AnturyXD/Soldering-stationV2/docs/images/t12-handle-internal-2.jpg

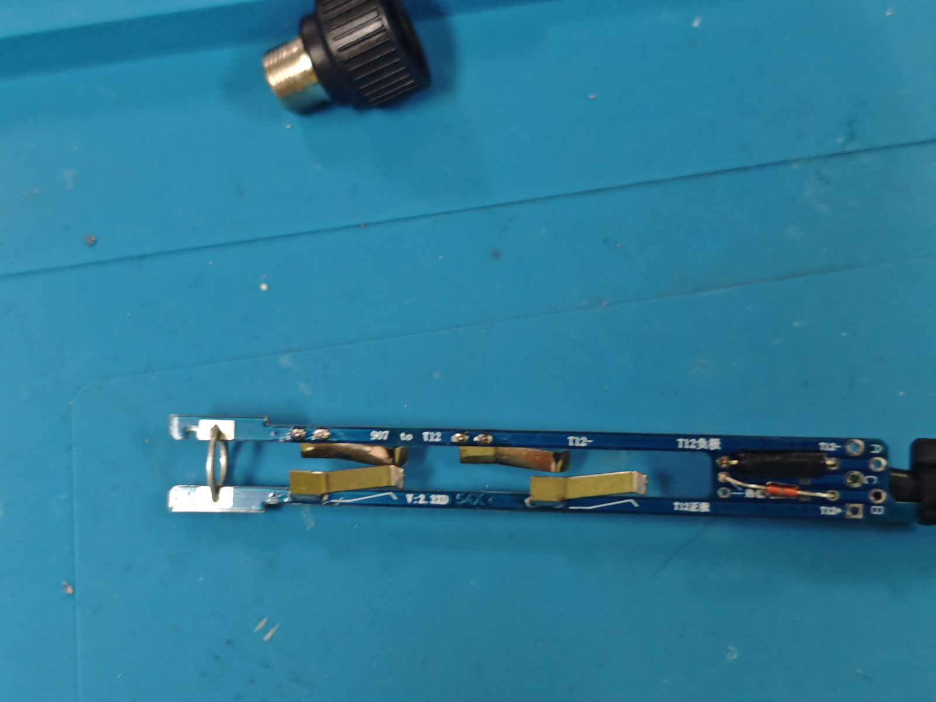
docs/images/t12-handle-internal-2.jpg
