AnturyXD/Soldering-stationV2/拓展板/Hardware/BOM_Board1_Schematic1_2026-06-07.xlsx

No. | Quantity | Comment | Designator | Footprint | Value | Manufacturer Part | Manufacturer | Supplier Part | Supplier | Name | Color
1 | 1 | 100uF | C1 | CAP-SMD_BD6.3-L6.6-W6.6-LS7.3-FD-H7.7 | 100uF | JVJ50V100M6x8 | JIERR(捷而瑞) | C46550415 | LCSC | 100uF
2 | 5 | 22pF | C2,C8,C9,C12,C13 | C0603 | 22pF | CL10C220JB8NNNC | SAMSUNG(三星) | C1653 | LCSC | 22pF
3 | 2 | 10uF | C3,C5 | C0603 | 10uF | CL10A106KP8NNNC | SAMSUNG(三星) | C19702 | LCSC | 10uF
4 | 10 | 100nF | C4,C6,C10,C11,C14,C15,C16,C17,C18,C19 | C0603 | 100nF | CGA0603X7R104K500JT | HRE(芯声) | C6119867 | LCSC | 100nF
5 | 1 | 220uF | C7 | CAP-SMD_BD10.0-L10.3-W10.3-LS11.7-FD | 220uF | JVJ50V220M10x10 | JIERR(捷而瑞) | C46550417 | LCSC | 220uF
6 | 2 | WJ2EDGVC-5.08-02P-14-00A | CN1,CN3 | CONN-TH_WJ2EDGVC-5.08-2P |  | WJ2EDGVC-5.08-02P-14-00A | KANGNEX(康奈克斯电气) | C8445 | LCSC | WJ2EDGVC-5.08-02P-14-00A | 绿色
7 | 1 | HX25003-3A | CN2 | CONN-TH_3P-P2.50_HX25003-3A |  | HX25003-3A | HX(红星) | C442300 | LCSC | HX25003-3A | 白色
8 | 4 | HX25003-2A | CN4,CN5,CN6,CN7 | CONN-TH_2P-P2.50_HX25003-2A |  | HX25003-2A | HX(红星) | C442299 | LCSC | HX25003-2A | 白色
9 | 1 | SS34 | D1 | SMA_L4.3-W2.6-LS5.2-RD |  | SS34 | MDD(辰达半导体) | C8678 | LCSC | SS34
10 | 3 | LL4148-GS08 | D2,D3,D4 | SOD-80_L3.5-W1.5-RD |  | LL4148-GS08 | VISHAY(威世) | C68883 | LCSC | LL4148-GS08
11 | 1 | PZ254V-11-04P | H1 | HDR-TH_4P-P2.54-V-M |  | PZ254V-11-04P | XFCN(兴飞) | C2691448 | LCSC | PZ254V-11-04P | 黑色
12 | 1 | PM254V-11-07-H85 | H2 | HDR-TH_7P-P2.54-V-F |  | PM254V-11-07-H85 | XFCN(兴飞) | C2832270 | LCSC | PM254V-11-07-H85
13 | 1 | PM254V-12-08-H85 | H3 | HDR-TH_8P-P2.54-V-F-R2-C4-S2.54 |  | PM254V-12-08-H85 | XFCN(兴飞) | C2834799 | LCSC | PM254V-12-08-H85
14 | 1 | 2.2uH | L1 | IND-SMD_L4.4-W4.2 | 2.2uH | FXL0420-2R2-M | cjiang(长江微电) | C167206 | LCSC | 2.2uH
15 | 1 | 47uH | L2 | IND-SMD_L12.3-W12.3 | 47uH | CDRH127N-470M | MINGSTAR(登壹) | C962356 | LCSC | 47uH
16 | 1 | NCD0603R1 | LED1 | LED0603-RD_RED |  | NCD0603R1 | 国星光电 | C84263 | LCSC | NCD0603R1
17 | 2 | NCD0603C1 | LED2,LED3 | LED0603-RD |  | NCD0603C1 | 国星光电 | C84264 | LCSC | NCD0603C1
18 | 3 | 19-219/GHC-YR2T1B5Y/3T | LED4,LED5,LED6 | LED-SMD_L1.6-W0.8_19-219-GHC-YR2T1B5Y-3T |  | 19-219/GHC-YR2T1B5Y/3T | EVERLIGHT(亿光) | C2994781 | LCSC | 19-219/GHC-YR2T1B5Y/3T
19 | 3 | S8050 J3Y | Q1,Q2,Q3 | SOT-23-3_L2.9-W1.3-P0.95-LS2.4-BR |  | S8050 J3Y | TDSEMIC(拓电半导体) | C42441446 | LCSC | S8050 J3Y
20 | 2 | 5.1kΩ | R1,R4 | R0603 | 5.1kΩ | 0603WAF5101T5E | UNI-ROYAL(厚声) | C23186 | LCSC | 5.1kΩ
21 | 1 | 100kΩ | R2 | R0603 | 100kΩ | 0603WAF1003T5E | UNI-ROYAL(厚声) | C25803 | LCSC | 100kΩ
22 | 1 | 22.1kΩ | R3 | R0603 | 22.1kΩ | FRC0603F2212TS | FOJAN(富捷) | C2960862 | LCSC | 22.1kΩ
23 | 3 | 1kΩ | R5,R6,R7 | R0603 | 1kΩ | FRC0603F1001TS | FOJAN(富捷) | C2907002 | LCSC | 1kΩ
24 | 4 | 10kΩ | R8,R9,R10,R12 | R0805 | 10kΩ | 0805W8F1002T5E | UNI-ROYAL(厚声) | C17414 | LCSC | 10kΩ
25 | 1 | 1.5kΩ | R11 | R0805 | 1.5kΩ | 0805W8F1501T5E | UNI-ROYAL(厚声) | C4310 | LCSC | 1.5kΩ
26 | 3 | 1.2kΩ | R13,R16,R19 | R0805 | 1.2kΩ | 0805W8F1201T5E | UNI-ROYAL(厚声) | C17379 | LCSC | 1.2kΩ
27 | 3 | 470Ω | R14,R17,R20 | R0805 | 470Ω | 0805W8F4700T5E | UNI-ROYAL(厚声) | C17710 | LCSC | 470Ω
28 | 3 | 2kΩ | R15,R18,R21 | R0805 | 2kΩ | 0805W8F2001T5E | UNI-ROYAL(厚声) | C17604 | LCSC | 2kΩ
29 | 3 | SRD-05VDC-SL-C | RLY1,RLY2,RLY3 | RELAY-TH_SRD-XXVDC-XL-C |  | SRD-05VDC-SL-C | 松乐 | C35449 | LCSC | SRD-05VDC-SL-C
30 | 4 | M3螺丝 | SCREW1,SCREW2,SCREW3,SCREW4 | M3螺丝
31 | 3 | KH-6X6X5H-STM | SW1,SW2,SW3 | SW-SMD_4P-L6.0-W6.0-P4.50-LS9.0_H5.0 |  | KH-6X6X5H-STM | kinghelm(金航标) | C2837531 | LCSC | KH-6X6X5H-STM
32 | 1 | SY8089AAAC | U1 | SOT-23-5_L3.0-W1.7-P0.95-LS2.8-BR |  | SY8089AAAC | Silergy(矽力杰) | C78988 | LCSC | SY8089AAAC
33 | 1 | CH213K | U2 | SOT-23-3_L2.9-W1.6-P1.90-LS2.8-BR |  | CH213K | WCH(南京沁恒) | C5456874 | LCSC | CH213K
34 | 1 | LM2596S-5.0/NOPB | U3 | TO-263-5_L10.2-W8.6-P1.70-LS14.4-BR |  | LM2596S-5.0/NOPB | TI(德州仪器) | C116713 | LCSC | LM2596S-5.0/NOPB
35 | 1 | STM32F103C8T6 | U4 | LQFP-48_L7.0-W7.0-P0.50-LS9.0-BL |  | STM32F103C8T6 | ST(意法半导体) | C8734 | LCSC | STM32F103C8T6
36 | 1 | CH340N | U5 | SOP-8_L4.9-W3.9-P1.27-LS6.0-BL |  | CH340N | WCH(南京沁恒) | C2977777 | LCSC | CH340N
37 | 1 | HDGCPH-PZ01-20 | U6 | HDR-TH_20P-P2.54-V-M_1 |  | HDGCPH-PZ01-20 | HDGC(华德共创) | C19190986 | LCSC | HDGCPH-PZ01-20 | 黑色
38 | 3 | LTV-354T-A | U7,U8,U9 | SOP-4_L3.9-W4.4-P2.54-LS7.0-TL |  | LTV-354T-A | LITEON(光宝) | C10802 | LCSC | LTV-354T-A
39 | 1 | TYPE-C 16PIN 2MD(073) | USB1 | USB-C-SMD_TYPE-C-16PIN-2MD-073 |  | TYPE-C 16PIN 2MD(073) | SHOU HAN(首韩) | C2765186 | LCSC | TYPE-C 16PIN 2MD(073)
40 | 1 | 8MHz | X1 | CRYSTAL-SMD_L5.0-W3.2 | 8MHz | X50328MSB2GI | YXC(扬兴晶振) | C115962 | LCSC | 8MHz
41 | 1 | 32.768kHz | X2 | CRYSTAL-SMD_L3.2-W1.5-1 | 32.768kHz | XKXGI-SUA-32.768K | YXC(扬兴晶振) | C5213671 | LCSC | 32.768kHz
