AnturyXD/Soldering-stationV2/控温板/Hardware/BOM_T12焊台温控_智能焊台控制板_2026-06-07.xlsx

No. | Quantity | Comment | Designator | Footprint | Value | Manufacturer Part | Manufacturer | Supplier Part | Supplier | Name | Color
1 | 1 | 2.7kHz | BUZZER2 | BUZ-TH_BD9.0-P4.00-D0.6-FD | 2.7kHz | QMB-09B-03 | 华能 | C96256 | LCSC | 2.7kHz
2 | 2 | 22pF | C1,C2 | C0603 | 22pF | CL10C220JB8NNNC | SAMSUNG(三星) | C1653 | LCSC | 22pF
3 | 6 | 100nF | C3,C4,C6,C8,C9,C13 | C0603 | 100nF | CGA0603X7R104K500JT | HRE(芯声) | C6119867 | LCSC | 100nF
4 | 1 | 47uF | C5 | CAP-TH_BD8.0-P3.50-D0.6-FD | 47uF | PA100V47M8X11 | JIERR(捷而瑞) | C49233039 | LCSC | 47uF
5 | 1 | 10uF | C7 | C0603 | 10uF | HGC0603R5106M350NTHJ | Chinocera(华瓷) | C22367827 | LCSC | 10uF
6 | 1 | 22uF | C10 | CAP-SMD_BD5.0-L5.3-W5.3-LS6.0-FD-H5.7 | 22uF | JVE35V22M5X6 | JIERR(捷而瑞) | C48615118 | LCSC | 22uF
7 | 1 | 1uF | C11 | C0603 | 1uF | CL10A105KB8NNNC | SAMSUNG(三星) | C15849 | LCSC | 1uF
8 | 1 | 2.2nF | C12 | C0603 | 2.2nF | FCC0603B222K500CT | FOJAN(富捷) | C5137562 | LCSC | 2.2nF
9 | 1 | HX25003-2A | CN2 | CONN-TH_2P-P2.50_HX25003-2A |  | HX25003-2A | HX(红星) | C442299 | LCSC | HX25003-2A | 白色
10 | 1 | SS54 | D1 | SMB_L4.3-W3.6-LS5.4-RD |  | SS54 | HXY MOSFET(华轩阳电子) | C5200096 | LCSC | SS54
11 | 1 | BZT52C18 | D2 | SOD-123_L2.7-W1.6-LS3.7-RD |  | BZT52C18 | R+O(宏嘉诚) | C19077414 | LCSC | BZT52C18
12 | 1 | LUDZS5.1BT1G | D3 | SOD-323_L1.8-W1.3-LS2.5-RD |  | LUDZS5.1BT1G | LRC(乐山无线电) | C49585 | LCSC | LUDZS5.1BT1G
13 | 2 | 1N4148WS | D4,D6 | SOD-323_L1.8-W1.3-LS2.5-RD |  | 1N4148WS | CJ(江苏长电/长晶) | C2128 | LCSC | 1N4148WS
14 | 1 | PZ254V-12-6P | J1 | HDR-TH_6P-P2.54-V-M-R2-C3-S2.54 |  | PZ254V-12-6P | XFCN(兴飞) | C492420 | LCSC | PZ254V-12-6P | 黑色
15 | 2 | PZ254V-11-01P | J2,J3 | HDR-TH_1P-P2.54-V-M |  | PZ254V-11-01P | XFCN(兴飞) | C492400 | LCSC | PZ254V-11-01P | 黑色
16 | 1 | KH-6X6X5H-STM | KEY1 | SW-SMD_4P-L6.0-W6.0-P4.50-LS9.0_H5.0 |  | KH-6X6X5H-STM | kinghelm(金航标) | C2837531 | LCSC | KH-6X6X5H-STM
17 | 1 | YLED0603B | LED1 | LED0603-FD |  | YLED0603B | YONGYUTAI(永裕泰) | C19171394 | LCSC | YLED0603B
18 | 1 | HS96L03W2C03 | OLED1 | OLED-TH_L27.8-W27.2-P2.54_C9900033791 |  | HS96L03W2C03 | HS(汉昇) | C5248080 | LCSC | HS96L03W2C03
19 | 1 | Aviator Socket | P1 | GX12-5 |  | GX16-5-01 |  |  |  | Aviator Socket
20 | 1 | WJ2EDGVC-5.08-02P-14-00A | P2 | CONN-TH_WJ2EDGVC-5.08-2P |  | WJ2EDGVC-5.08-02P-14-00A | KANGNEX(康奈克斯电气) | C8445 | LCSC | WJ2EDGVC-5.08-02P-14-00A | 绿色
21 | 1 | IRLR7843TRPBF | Q1 | TO-252-2_L6.5-W6.1-P4.58-LS10.0-TR |  | IRLR7843TRPBF | Infineon(英飞凌) | C21988 | LCSC | IRLR7843TRPBF
22 | 1 | FMMT619TA-HXY | Q2 | SOT-23-3_L2.9-W1.6-P1.90-LS2.8-BR |  | FMMT619TA-HXY | HXY MOSFET(华轩阳电子) | C47506859 | LCSC | FMMT619TA-HXY
23 | 1 | SS8050 | Q4 | SOT-23-3_L2.9-W1.3-P1.90-LS2.4-BR |  | SS8050 | R+O(宏嘉诚) | C7420370 | LCSC | SS8050
24 | 12 | 10kΩ | R1,R2,R3,R5,R7,R8,R9,R10,R13,R14,R17,R19 | R0603 | 10kΩ | FRC0603J103 TS | FOJAN(富捷) | C2930027 | LCSC | 10kΩ
25 | 1 | 1kΩ | R4 | R1206 | 1kΩ | 1206W4F1001T5E | UNI-ROYAL(厚声) | C4410 | LCSC | 1kΩ
26 | 1 | 47kΩ | R6 | R0603 | 47kΩ | FRC0603F4702TS | FOJAN(富捷) | C2907042 | LCSC | 47kΩ
27 | 1 | 200kΩ | R11 | R0603 | 200kΩ | 0603WAF2003T5E | UNI-ROYAL(厚声) | C25811 | LCSC | 200kΩ
28 | 1 | 1kΩ | R12 | R0603 | 1kΩ | FRC0603F1001TS | FOJAN(富捷) | C2907002 | LCSC | 1kΩ
29 | 1 | 1.5kΩ | R16 | R0603 | 1.5kΩ | FRC0603F1501TS | FOJAN(富捷) | C2930050 | LCSC | 1.5kΩ
30 | 1 | 20kΩ | R18 | R0603 | 20kΩ | FRC0603F2002TS | FOJAN(富捷) | C2907011 | LCSC | 20kΩ
31 | 1 | EC11E153440D | SW1 | SW-TH_EC11XXXXXXXX |  | EC11E153440D | ALPSALPINE(阿尔卑斯阿尔派) | C370992 | LCSC | EC11E153440D
32 | 1 | ATMEGA328P-AU | U1 | TQFP-32_L7.0-W7.0-P0.80-LS9.0-BL |  | ATMEGA328P-AU | MICROCHIP(美国微芯) | C14877 | LCSC | ATMEGA328P-AU
33 | 1 | L78M05ABDT-TR | U2 | TO-252-2_L6.5-W6.1-P4.58-LS10.0-TL |  | L78M05ABDT-TR | ST(意法半导体) | C58069 | LCSC | L78M05ABDT-TR
34 | 1 | OPA2333AIDR | U3 | SOP-8_L4.9-W3.9-P1.27-LS6.0-BL |  | OPA2333AIDR | TI(德州仪器) | C38732 | LCSC | OPA2333AIDR
35 | 1 | 16MHz | X1 | CRYSTAL-SMD_4P-L3.2-W2.5-BL | 16MHz | X322516MLB4SI | YXC(扬兴晶振) | C13738 | LCSC | 16MHz
