AnturyXD/Soldering-stationV2/ATmega-Soldering-Station-master/3dprint/SolderingStationV2_knob.fcstd

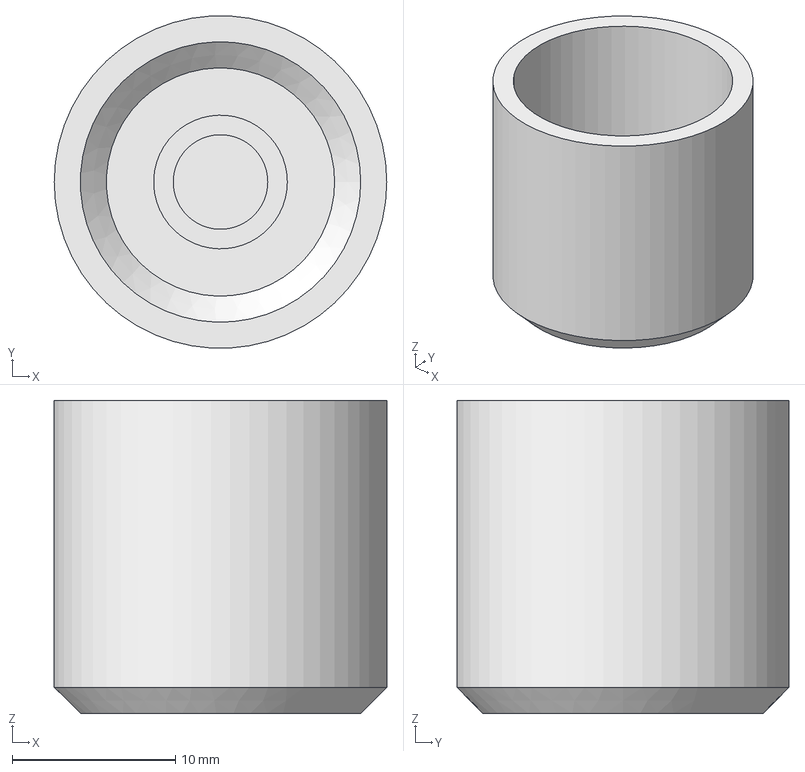
[picture p21: CAD file, 2026-06-06, last stored version]
ATmega-Soldering-Station-master/3dprint/SolderingStationV2_knob.fcstd
20.4 x 20.4 x 19.2 mm
