AnturyXD/Soldering-stationV2/ATmega-Soldering-Station-master/3dprint/SolderungStationV2_Case_ESD.fcstd

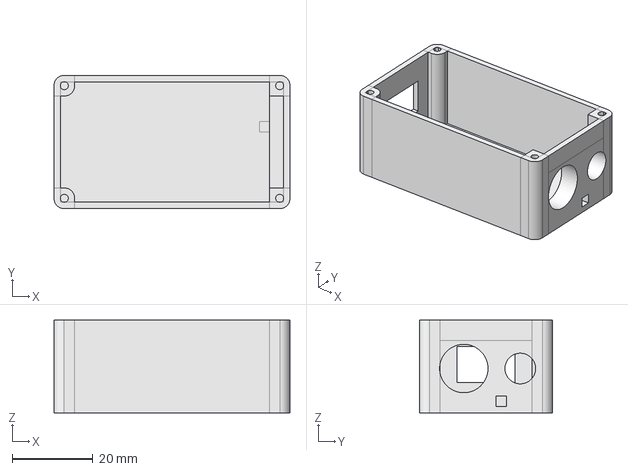
[picture p22: CAD file, 2026-06-06, last stored version]
ATmega-Soldering-Station-master/3dprint/SolderungStationV2_Case_ESD.fcstd
58.5 x 33.0 x 23.0 mm
