AnturyXD/Soldering-stationV2/(list of files, cad)

Other CAD files:
ATmega-Soldering-Station-master/3dprint/SolderingStationV2_knob.stl
ATmega-Soldering-Station-master/3dprint/SolderungStationV2_Case_ESD.stl
