AnturyXD/Soldering-stationV2/拓展板/Firmware/SmartSolder_Extension/C8T6/USER/Objects/SmartSolder_Extension.htm

# Static Call Graph for image .\Objects\SmartSolder_Extension.axf

#<CALLGRAPH># ARM Linker, 5060750: Last Updated: Wed Jun 10 21:04:14 2026

### Maximum Stack Usage = 328 bytes + Unknown(Cycles, Untraceable Function Pointers)

### Call chain for Maximum Stack Depth:

main ⇒ App_ReportTask ⇒ DebugUart_Printf ⇒ DebugUart_PushByte ⇒ DebugUart_KickLocked

### Mutually Recursive functions

- ADC1_2_IRQHandler ⇒ ADC1_2_IRQHandler

### Function Pointers

- ADC1_2_IRQHandler from startup_stm32f10x_md.o(.text) referenced from startup_stm32f10x_md.o(RESET)
- BusFault_Handler from stm32f10x_it.o(i.BusFault_Handler) referenced from startup_stm32f10x_md.o(RESET)
- CAN1_RX1_IRQHandler from startup_stm32f10x_md.o(.text) referenced from startup_stm32f10x_md.o(RESET)
- CAN1_SCE_IRQHandler from startup_stm32f10x_md.o(.text) referenced from startup_stm32f10x_md.o(RESET)
- DMA1_Channel1_IRQHandler from startup_stm32f10x_md.o(.text) referenced from startup_stm32f10x_md.o(RESET)
- DMA1_Channel2_IRQHandler from startup_stm32f10x_md.o(.text) referenced from startup_stm32f10x_md.o(RESET)
- DMA1_Channel3_IRQHandler from st7789.o(i.DMA1_Channel3_IRQHandler) referenced from startup_stm32f10x_md.o(RESET)
- DMA1_Channel4_IRQHandler from debug_uart.o(i.DMA1_Channel4_IRQHandler) referenced from startup_stm32f10x_md.o(RESET)
- DMA1_Channel5_IRQHandler from startup_stm32f10x_md.o(.text) referenced from startup_stm32f10x_md.o(RESET)
- DMA1_Channel6_IRQHandler from startup_stm32f10x_md.o(.text) referenced from startup_stm32f10x_md.o(RESET)
- DMA1_Channel7_IRQHandler from startup_stm32f10x_md.o(.text) referenced from startup_stm32f10x_md.o(RESET)
- DebugMon_Handler from stm32f10x_it.o(i.DebugMon_Handler) referenced from startup_stm32f10x_md.o(RESET)
- EXTI0_IRQHandler from startup_stm32f10x_md.o(.text) referenced from startup_stm32f10x_md.o(RESET)
- EXTI15_10_IRQHandler from startup_stm32f10x_md.o(.text) referenced from startup_stm32f10x_md.o(RESET)
- EXTI1_IRQHandler from startup_stm32f10x_md.o(.text) referenced from startup_stm32f10x_md.o(RESET)
- EXTI2_IRQHandler from startup_stm32f10x_md.o(.text) referenced from startup_stm32f10x_md.o(RESET)
- EXTI3_IRQHandler from startup_stm32f10x_md.o(.text) referenced from startup_stm32f10x_md.o(RESET)
- EXTI4_IRQHandler from startup_stm32f10x_md.o(.text) referenced from startup_stm32f10x_md.o(RESET)
- EXTI9_5_IRQHandler from startup_stm32f10x_md.o(.text) referenced from startup_stm32f10x_md.o(RESET)
- FLASH_IRQHandler from startup_stm32f10x_md.o(.text) referenced from startup_stm32f10x_md.o(RESET)
- HardFault_Handler from stm32f10x_it.o(i.HardFault_Handler) referenced from startup_stm32f10x_md.o(RESET)
- I2C1_ER_IRQHandler from startup_stm32f10x_md.o(.text) referenced from startup_stm32f10x_md.o(RESET)
- I2C1_EV_IRQHandler from startup_stm32f10x_md.o(.text) referenced from startup_stm32f10x_md.o(RESET)
- I2C2_ER_IRQHandler from startup_stm32f10x_md.o(.text) referenced from startup_stm32f10x_md.o(RESET)
- I2C2_EV_IRQHandler from startup_stm32f10x_md.o(.text) referenced from startup_stm32f10x_md.o(RESET)
- MemManage_Handler from stm32f10x_it.o(i.MemManage_Handler) referenced from startup_stm32f10x_md.o(RESET)
- NMI_Handler from stm32f10x_it.o(i.NMI_Handler) referenced from startup_stm32f10x_md.o(RESET)
- PVD_IRQHandler from startup_stm32f10x_md.o(.text) referenced from startup_stm32f10x_md.o(RESET)
- PendSV_Handler from stm32f10x_it.o(i.PendSV_Handler) referenced from startup_stm32f10x_md.o(RESET)
- RCC_IRQHandler from startup_stm32f10x_md.o(.text) referenced from startup_stm32f10x_md.o(RESET)
- RTCAlarm_IRQHandler from startup_stm32f10x_md.o(.text) referenced from startup_stm32f10x_md.o(RESET)
- RTC_IRQHandler from startup_stm32f10x_md.o(.text) referenced from startup_stm32f10x_md.o(RESET)
- Reset_Handler from startup_stm32f10x_md.o(.text) referenced from startup_stm32f10x_md.o(RESET)
- SPI1_IRQHandler from startup_stm32f10x_md.o(.text) referenced from startup_stm32f10x_md.o(RESET)
- SPI2_IRQHandler from startup_stm32f10x_md.o(.text) referenced from startup_stm32f10x_md.o(RESET)
- SVC_Handler from stm32f10x_it.o(i.SVC_Handler) referenced from startup_stm32f10x_md.o(RESET)
- SysTick_Handler from stm32f10x_it.o(i.SysTick_Handler) referenced from startup_stm32f10x_md.o(RESET)
- TAMPER_IRQHandler from startup_stm32f10x_md.o(.text) referenced from startup_stm32f10x_md.o(RESET)
- TIM1_BRK_IRQHandler from startup_stm32f10x_md.o(.text) referenced from startup_stm32f10x_md.o(RESET)
- TIM1_CC_IRQHandler from startup_stm32f10x_md.o(.text) referenced from startup_stm32f10x_md.o(RESET)
- TIM1_TRG_COM_IRQHandler from startup_stm32f10x_md.o(.text) referenced from startup_stm32f10x_md.o(RESET)
- TIM1_UP_IRQHandler from startup_stm32f10x_md.o(.text) referenced from startup_stm32f10x_md.o(RESET)
- TIM2_IRQHandler from startup_stm32f10x_md.o(.text) referenced from startup_stm32f10x_md.o(RESET)
- TIM3_IRQHandler from timer.o(i.TIM3_IRQHandler) referenced from startup_stm32f10x_md.o(RESET)
- TIM4_IRQHandler from startup_stm32f10x_md.o(.text) referenced from startup_stm32f10x_md.o(RESET)
- USART1_IRQHandler from startup_stm32f10x_md.o(.text) referenced from startup_stm32f10x_md.o(RESET)
- USART2_IRQHandler from esp_uart.o(i.USART2_IRQHandler) referenced from startup_stm32f10x_md.o(RESET)
- USART3_IRQHandler from lower_uart.o(i.USART3_IRQHandler) referenced from startup_stm32f10x_md.o(RESET)
- USBWakeUp_IRQHandler from startup_stm32f10x_md.o(.text) referenced from startup_stm32f10x_md.o(RESET)
- USB_HP_CAN1_TX_IRQHandler from startup_stm32f10x_md.o(.text) referenced from startup_stm32f10x_md.o(RESET)
- USB_LP_CAN1_RX0_IRQHandler from startup_stm32f10x_md.o(.text) referenced from startup_stm32f10x_md.o(RESET)
- UsageFault_Handler from stm32f10x_it.o(i.UsageFault_Handler) referenced from startup_stm32f10x_md.o(RESET)
- WWDG_IRQHandler from startup_stm32f10x_md.o(.text) referenced from startup_stm32f10x_md.o(RESET)
- __main from entry.o(.ARM.Collect$$$$00000000) referenced from startup_stm32f10x_md.o(.text)
- _snputc from printfa.o(i._snputc) referenced from printfa.o(i.__0snprintf)
- _snputc from printfa.o(i._snputc) referenced from printfa.o(i.__0vsnprintf)
- main from main.o(i.main) referenced from entry9a.o(.ARM.Collect$$$$0000000B)

### Global Symbols

__main (Thumb, 0 bytes, Stack size unknown bytes, entry.o(.ARM.Collect$$$$00000000))
[Address Reference Count : 1]

- startup_stm32f10x_md.o(.text)

_main_stk (Thumb, 0 bytes, Stack size unknown bytes, entry2.o(.ARM.Collect$$$$00000001))

_main_scatterload (Thumb, 0 bytes, Stack size unknown bytes, entry5.o(.ARM.Collect$$$$00000004))

[Calls]

- >> __scatterload

__main_after_scatterload (Thumb, 0 bytes, Stack size unknown bytes, entry5.o(.ARM.Collect$$$$00000004))

[Called By]

- >> __scatterload

_main_clock (Thumb, 0 bytes, Stack size unknown bytes, entry7b.o(.ARM.Collect$$$$00000008))

_main_cpp_init (Thumb, 0 bytes, Stack size unknown bytes, entry8b.o(.ARM.Collect$$$$0000000A))

_main_init (Thumb, 0 bytes, Stack size unknown bytes, entry9a.o(.ARM.Collect$$$$0000000B))

__rt_final_cpp (Thumb, 0 bytes, Stack size unknown bytes, entry10a.o(.ARM.Collect$$$$0000000D))

__rt_final_exit (Thumb, 0 bytes, Stack size unknown bytes, entry11a.o(.ARM.Collect$$$$0000000F))

Reset_Handler (Thumb, 4 bytes, Stack size 0 bytes, startup_stm32f10x_md.o(.text))
[Address Reference Count : 1]

- startup_stm32f10x_md.o(RESET)

ADC1_2_IRQHandler (Thumb, 0 bytes, Stack size 0 bytes, startup_stm32f10x_md.o(.text))

[Calls]

- >> ADC1_2_IRQHandler

[Called By]

- >> ADC1_2_IRQHandler

[Address Reference Count : 1]

- startup_stm32f10x_md.o(RESET)

CAN1_RX1_IRQHandler (Thumb, 0 bytes, Stack size 0 bytes, startup_stm32f10x_md.o(.text))
[Address Reference Count : 1]

- startup_stm32f10x_md.o(RESET)

CAN1_SCE_IRQHandler (Thumb, 0 bytes, Stack size 0 bytes, startup_stm32f10x_md.o(.text))
[Address Reference Count : 1]

- startup_stm32f10x_md.o(RESET)

DMA1_Channel1_IRQHandler (Thumb, 0 bytes, Stack size 0 bytes, startup_stm32f10x_md.o(.text))
[Address Reference Count : 1]

- startup_stm32f10x_md.o(RESET)

DMA1_Channel2_IRQHandler (Thumb, 0 bytes, Stack size 0 bytes, startup_stm32f10x_md.o(.text))
[Address Reference Count : 1]

- startup_stm32f10x_md.o(RESET)

DMA1_Channel5_IRQHandler (Thumb, 0 bytes, Stack size 0 bytes, startup_stm32f10x_md.o(.text))
[Address Reference Count : 1]

- startup_stm32f10x_md.o(RESET)

DMA1_Channel6_IRQHandler (Thumb, 0 bytes, Stack size 0 bytes, startup_stm32f10x_md.o(.text))
[Address Reference Count : 1]

- startup_stm32f10x_md.o(RESET)

DMA1_Channel7_IRQHandler (Thumb, 0 bytes, Stack size 0 bytes, startup_stm32f10x_md.o(.text))
[Address Reference Count : 1]

- startup_stm32f10x_md.o(RESET)

EXTI0_IRQHandler (Thumb, 0 bytes, Stack size 0 bytes, startup_stm32f10x_md.o(.text))
[Address Reference Count : 1]

- startup_stm32f10x_md.o(RESET)

EXTI15_10_IRQHandler (Thumb, 0 bytes, Stack size 0 bytes, startup_stm32f10x_md.o(.text))
[Address Reference Count : 1]

- startup_stm32f10x_md.o(RESET)

EXTI1_IRQHandler (Thumb, 0 bytes, Stack size 0 bytes, startup_stm32f10x_md.o(.text))
[Address Reference Count : 1]

- startup_stm32f10x_md.o(RESET)

EXTI2_IRQHandler (Thumb, 0 bytes, Stack size 0 bytes, startup_stm32f10x_md.o(.text))
[Address Reference Count : 1]

- startup_stm32f10x_md.o(RESET)

EXTI3_IRQHandler (Thumb, 0 bytes, Stack size 0 bytes, startup_stm32f10x_md.o(.text))
[Address Reference Count : 1]

- startup_stm32f10x_md.o(RESET)

EXTI4_IRQHandler (Thumb, 0 bytes, Stack size 0 bytes, startup_stm32f10x_md.o(.text))
[Address Reference Count : 1]

- startup_stm32f10x_md.o(RESET)

EXTI9_5_IRQHandler (Thumb, 0 bytes, Stack size 0 bytes, startup_stm32f10x_md.o(.text))
[Address Reference Count : 1]

- startup_stm32f10x_md.o(RESET)

FLASH_IRQHandler (Thumb, 0 bytes, Stack size 0 bytes, startup_stm32f10x_md.o(.text))
[Address Reference Count : 1]

- startup_stm32f10x_md.o(RESET)

I2C1_ER_IRQHandler (Thumb, 0 bytes, Stack size 0 bytes, startup_stm32f10x_md.o(.text))
[Address Reference Count : 1]

- startup_stm32f10x_md.o(RESET)

I2C1_EV_IRQHandler (Thumb, 0 bytes, Stack size 0 bytes, startup_stm32f10x_md.o(.text))
[Address Reference Count : 1]

- startup_stm32f10x_md.o(RESET)

I2C2_ER_IRQHandler (Thumb, 0 bytes, Stack size 0 bytes, startup_stm32f10x_md.o(.text))
[Address Reference Count : 1]

- startup_stm32f10x_md.o(RESET)

I2C2_EV_IRQHandler (Thumb, 0 bytes, Stack size 0 bytes, startup_stm32f10x_md.o(.text))
[Address Reference Count : 1]

- startup_stm32f10x_md.o(RESET)

PVD_IRQHandler (Thumb, 0 bytes, Stack size 0 bytes, startup_stm32f10x_md.o(.text))
[Address Reference Count : 1]

- startup_stm32f10x_md.o(RESET)

RCC_IRQHandler (Thumb, 0 bytes, Stack size 0 bytes, startup_stm32f10x_md.o(.text))
[Address Reference Count : 1]

- startup_stm32f10x_md.o(RESET)

RTCAlarm_IRQHandler (Thumb, 0 bytes, Stack size 0 bytes, startup_stm32f10x_md.o(.text))
[Address Reference Count : 1]

- startup_stm32f10x_md.o(RESET)

RTC_IRQHandler (Thumb, 0 bytes, Stack size 0 bytes, startup_stm32f10x_md.o(.text))
[Address Reference Count : 1]

- startup_stm32f10x_md.o(RESET)

SPI1_IRQHandler (Thumb, 0 bytes, Stack size 0 bytes, startup_stm32f10x_md.o(.text))
[Address Reference Count : 1]

- startup_stm32f10x_md.o(RESET)

SPI2_IRQHandler (Thumb, 0 bytes, Stack size 0 bytes, startup_stm32f10x_md.o(.text))
[Address Reference Count : 1]

- startup_stm32f10x_md.o(RESET)

TAMPER_IRQHandler (Thumb, 0 bytes, Stack size 0 bytes, startup_stm32f10x_md.o(.text))
[Address Reference Count : 1]

- startup_stm32f10x_md.o(RESET)

TIM1_BRK_IRQHandler (Thumb, 0 bytes, Stack size 0 bytes, startup_stm32f10x_md.o(.text))
[Address Reference Count : 1]

- startup_stm32f10x_md.o(RESET)

TIM1_CC_IRQHandler (Thumb, 0 bytes, Stack size 0 bytes, startup_stm32f10x_md.o(.text))
[Address Reference Count : 1]

- startup_stm32f10x_md.o(RESET)

TIM1_TRG_COM_IRQHandler (Thumb, 0 bytes, Stack size 0 bytes, startup_stm32f10x_md.o(.text))
[Address Reference Count : 1]

- startup_stm32f10x_md.o(RESET)

TIM1_UP_IRQHandler (Thumb, 0 bytes, Stack size 0 bytes, startup_stm32f10x_md.o(.text))
[Address Reference Count : 1]

- startup_stm32f10x_md.o(RESET)

TIM2_IRQHandler (Thumb, 0 bytes, Stack size 0 bytes, startup_stm32f10x_md.o(.text))
[Address Reference Count : 1]

- startup_stm32f10x_md.o(RESET)

TIM4_IRQHandler (Thumb, 0 bytes, Stack size 0 bytes, startup_stm32f10x_md.o(.text))
[Address Reference Count : 1]

- startup_stm32f10x_md.o(RESET)

USART1_IRQHandler (Thumb, 0 bytes, Stack size 0 bytes, startup_stm32f10x_md.o(.text))
[Address Reference Count : 1]

- startup_stm32f10x_md.o(RESET)

USBWakeUp_IRQHandler (Thumb, 0 bytes, Stack size 0 bytes, startup_stm32f10x_md.o(.text))
[Address Reference Count : 1]

- startup_stm32f10x_md.o(RESET)

USB_HP_CAN1_TX_IRQHandler (Thumb, 0 bytes, Stack size 0 bytes, startup_stm32f10x_md.o(.text))
[Address Reference Count : 1]

- startup_stm32f10x_md.o(RESET)

USB_LP_CAN1_RX0_IRQHandler (Thumb, 0 bytes, Stack size 0 bytes, startup_stm32f10x_md.o(.text))
[Address Reference Count : 1]

- startup_stm32f10x_md.o(RESET)

WWDG_IRQHandler (Thumb, 0 bytes, Stack size 0 bytes, startup_stm32f10x_md.o(.text))
[Address Reference Count : 1]

- startup_stm32f10x_md.o(RESET)

__aeabi_memcpy (Thumb, 36 bytes, Stack size 0 bytes, memcpya.o(.text), UNUSED)

__aeabi_memcpy4 (Thumb, 0 bytes, Stack size 0 bytes, memcpya.o(.text))

[Called By]

- >> ESP01S_PopCommand
- >> DisplayUi_Task

__aeabi_memcpy8 (Thumb, 0 bytes, Stack size 0 bytes, memcpya.o(.text), UNUSED)

__aeabi_memset (Thumb, 14 bytes, Stack size 0 bytes, memseta.o(.text))

[Called By]

- >> ResetDrawCaches
- >> DrawBigDigit
- >> _memset$wrapper
- >> __aeabi_memclr

__aeabi_memset4 (Thumb, 0 bytes, Stack size 0 bytes, memseta.o(.text), UNUSED)

__aeabi_memset8 (Thumb, 0 bytes, Stack size 0 bytes, memseta.o(.text), UNUSED)

__aeabi_memclr (Thumb, 4 bytes, Stack size 0 bytes, memseta.o(.text), UNUSED)

[Calls]

- >> __aeabi_memset

__aeabi_memclr4 (Thumb, 0 bytes, Stack size 0 bytes, memseta.o(.text))

[Called By]

- >> AppState_Init
- >> HandleLine

__aeabi_memclr8 (Thumb, 0 bytes, Stack size 0 bytes, memseta.o(.text), UNUSED)

_memset$wrapper (Thumb, 18 bytes, Stack size 8 bytes, memseta.o(.text), UNUSED)

[Calls]

- >> __aeabi_memset

strstr (Thumb, 36 bytes, Stack size 12 bytes, strstr.o(.text))

[Stack]

- Max Depth = 12
- Call Chain = strstr

[Called By]

- >> ParseField

strncpy (Thumb, 24 bytes, Stack size 8 bytes, strncpy.o(.text))

[Stack]

- Max Depth = 8
- Call Chain = strncpy

[Called By]

- >> DrawWaitingInfo
- >> ESP01S_Task
- >> ApplyStatusFrame
- >> StoreIp

strchr (Thumb, 20 bytes, Stack size 0 bytes, strchr.o(.text))

[Called By]

- >> IsValidMode

strlen (Thumb, 14 bytes, Stack size 0 bytes, strlen.o(.text))

[Called By]

- >> ParseField

strcmp (Thumb, 28 bytes, Stack size 8 bytes, strcmp.o(.text))

[Stack]

- Max Depth = 8
- Call Chain = strcmp

[Called By]

- >> App_ProcessCommand

strcpy (Thumb, 18 bytes, Stack size 0 bytes, strcpy.o(.text))

[Called By]

- >> AppState_Init

strncmp (Thumb, 30 bytes, Stack size 12 bytes, strncmp.o(.text))

[Stack]

- Max Depth = 12
- Call Chain = strncmp

[Called By]

- >> DrawWaitingInfo
- >> ESP01S_Task
- >> ParseStatusFrame
- >> HandleLine

strtol (Thumb, 112 bytes, Stack size 32 bytes, strtol.o(.text))

[Stack]

- Max Depth = 72
- Call Chain = strtol ⇒ _strtoul

[Calls]

- >> _strtoul
- >> __aeabi_errno_addr
- >> __rt_ctype_table

[Called By]

- >> ParseNumber
- >> atoi

atoi (Thumb, 26 bytes, Stack size 16 bytes, atoi.o(.text))

[Stack]

- Max Depth = 88
- Call Chain = atoi ⇒ strtol ⇒ _strtoul

[Calls]

- >> __aeabi_errno_addr
- >> strtol

[Called By]

- >> HandleLine

__aeabi_uidiv (Thumb, 0 bytes, Stack size 12 bytes, uidiv.o(.text), UNUSED)

__aeabi_uidivmod (Thumb, 44 bytes, Stack size 12 bytes, uidiv.o(.text), UNUSED)

[Called By]

- >> _printf_core

__aeabi_uldivmod (Thumb, 98 bytes, Stack size 40 bytes, uldiv.o(.text), UNUSED)

[Calls]

- >> __aeabi_llsr
- >> __aeabi_llsl

[Called By]

- >> _printf_core
- >> _fp_digits

__rt_ctype_table (Thumb, 4 bytes, Stack size 0 bytes, ctype_o.o(.text))

[Called By]

- >> strtol

_strtoul (Thumb, 158 bytes, Stack size 40 bytes, _strtoul.o(.text))

[Stack]

- Max Depth = 40
- Call Chain = _strtoul

[Calls]

- >> __aeabi_errno_addr
- >> _chval

[Called By]

- >> strtol

__I$use$fp (Thumb, 0 bytes, Stack size 48 bytes, iusefp.o(.text), UNUSED)

__aeabi_dadd (Thumb, 322 bytes, Stack size 48 bytes, dadd.o(.text), UNUSED)

[Calls]

- >> __aeabi_lasr
- >> __aeabi_llsl
- >> _double_round
- >> _double_epilogue

[Called By]

- >> __aeabi_drsub
- >> __aeabi_dsub
- >> _fp_digits

__aeabi_dsub (Thumb, 6 bytes, Stack size 0 bytes, dadd.o(.text), UNUSED)

[Calls]

- >> __aeabi_dadd

__aeabi_drsub (Thumb, 6 bytes, Stack size 0 bytes, dadd.o(.text), UNUSED)

[Calls]

- >> __aeabi_dadd

__aeabi_dmul (Thumb, 228 bytes, Stack size 48 bytes, dmul.o(.text), UNUSED)

[Calls]

- >> _double_epilogue

[Called By]

- >> _fp_digits

__aeabi_ddiv (Thumb, 222 bytes, Stack size 32 bytes, ddiv.o(.text), UNUSED)

[Calls]

- >> _double_round

[Called By]

- >> _fp_digits

__aeabi_d2ulz (Thumb, 48 bytes, Stack size 0 bytes, dfixul.o(.text), UNUSED)

[Calls]

- >> __aeabi_llsr
- >> __aeabi_llsl

[Called By]

- >> _fp_digits

__aeabi_cdrcmple (Thumb, 48 bytes, Stack size 0 bytes, cdrcmple.o(.text), UNUSED)

[Called By]

- >> _fp_digits

__scatterload (Thumb, 28 bytes, Stack size 0 bytes, init.o(.text))

[Calls]

- >> __main_after_scatterload

[Called By]

- >> _main_scatterload

__scatterload_rt2 (Thumb, 0 bytes, Stack size 0 bytes, init.o(.text), UNUSED)

__aeabi_llsl (Thumb, 30 bytes, Stack size 0 bytes, llshl.o(.text), UNUSED)

[Called By]

- >> _double_epilogue
- >> __aeabi_uldivmod
- >> __aeabi_dadd
- >> __aeabi_d2ulz

_ll_shift_l (Thumb, 0 bytes, Stack size 0 bytes, llshl.o(.text), UNUSED)

__aeabi_llsr (Thumb, 32 bytes, Stack size 0 bytes, llushr.o(.text), UNUSED)

[Called By]

- >> _double_epilogue
- >> __aeabi_uldivmod
- >> __aeabi_d2ulz

_ll_ushift_r (Thumb, 0 bytes, Stack size 0 bytes, llushr.o(.text), UNUSED)

__aeabi_lasr (Thumb, 36 bytes, Stack size 0 bytes, llsshr.o(.text), UNUSED)

[Called By]

- >> __aeabi_dadd

_ll_sshift_r (Thumb, 0 bytes, Stack size 0 bytes, llsshr.o(.text), UNUSED)

_chval (Thumb, 28 bytes, Stack size 0 bytes, _chval.o(.text))

[Called By]

- >> _strtoul

_double_round (Thumb, 30 bytes, Stack size 8 bytes, depilogue.o(.text), UNUSED)

[Called By]

- >> _double_epilogue
- >> __aeabi_ddiv
- >> __aeabi_dadd

_double_epilogue (Thumb, 156 bytes, Stack size 32 bytes, depilogue.o(.text), UNUSED)

[Calls]

- >> __aeabi_llsr
- >> __aeabi_llsl
- >> _double_round

[Called By]

- >> __aeabi_dmul
- >> __aeabi_dadd

AppMode_ToText (Thumb, 14 bytes, Stack size 0 bytes, app_state.o(i.AppMode_ToText))

[Called By]

- >> ESP01S_SendState
- >> App_ReportTask

AppState_Init (Thumb, 80 bytes, Stack size 8 bytes, app_state.o(i.AppState_Init))

[Stack]

- Max Depth = 8
- Call Chain = AppState_Init

[Calls]

- >> strcpy
- >> __aeabi_memclr4

[Called By]

- >> App_Init

BoardIo_Init (Thumb, 80 bytes, Stack size 8 bytes, board_io.o(i.BoardIo_Init))

[Stack]

- Max Depth = 32
- Call Chain = BoardIo_Init ⇒ GPIO_Init

[Calls]

- >> RCC_APB2PeriphClockCmd
- >> GPIO_Init
- >> GPIO_SetBits
- >> GPIO_ResetBits

[Called By]

- >> App_Init

BoardIo_Task (Thumb, 88 bytes, Stack size 16 bytes, board_io.o(i.BoardIo_Task))

[Stack]

- Max Depth = 16
- Call Chain = BoardIo_Task

[Calls]

- >> GPIO_SetBits
- >> GPIO_ResetBits

[Called By]

- >> main

BusFault_Handler (Thumb, 4 bytes, Stack size 0 bytes, stm32f10x_it.o(i.BusFault_Handler))
[Address Reference Count : 1]

- startup_stm32f10x_md.o(RESET)

DMA1_Channel3_IRQHandler (Thumb, 72 bytes, Stack size 8 bytes, st7789.o(i.DMA1_Channel3_IRQHandler))

[Stack]

- Max Depth = 8
- Call Chain = DMA1_Channel3_IRQHandler

[Calls]

- >> DMA_GetITStatus
- >> DMA_Cmd
- >> DMA_ClearITPendingBit

[Address Reference Count : 1]

- startup_stm32f10x_md.o(RESET)

DMA1_Channel4_IRQHandler (Thumb, 98 bytes, Stack size 8 bytes, debug_uart.o(i.DMA1_Channel4_IRQHandler))

[Stack]

- Max Depth = 16
- Call Chain = DMA1_Channel4_IRQHandler ⇒ DebugUart_KickLocked

[Calls]

- >> DMA_GetITStatus
- >> DMA_Cmd
- >> DMA_ClearITPendingBit
- >> DebugUart_KickLocked

[Address Reference Count : 1]

- startup_stm32f10x_md.o(RESET)

DMA_ClearFlag (Thumb, 18 bytes, Stack size 0 bytes, stm32f10x_dma.o(i.DMA_ClearFlag))

[Called By]

- >> DebugUart_KickLocked
- >> ST7789_StartDma

DMA_ClearITPendingBit (Thumb, 18 bytes, Stack size 0 bytes, stm32f10x_dma.o(i.DMA_ClearITPendingBit))

[Called By]

- >> DMA1_Channel4_IRQHandler
- >> DMA1_Channel3_IRQHandler

DMA_Cmd (Thumb, 24 bytes, Stack size 0 bytes, stm32f10x_dma.o(i.DMA_Cmd))

[Called By]

- >> DMA1_Channel4_IRQHandler
- >> DebugUart_KickLocked
- >> DMA1_Channel3_IRQHandler
- >> ST7789_StartDma

DMA_DeInit (Thumb, 324 bytes, Stack size 0 bytes, stm32f10x_dma.o(i.DMA_DeInit))

[Called By]

- >> DebugUart_Init
- >> ST7789_GPIO_Init

DMA_GetITStatus (Thumb, 36 bytes, Stack size 0 bytes, stm32f10x_dma.o(i.DMA_GetITStatus))

[Called By]

- >> DMA1_Channel4_IRQHandler
- >> DMA1_Channel3_IRQHandler

DMA_ITConfig (Thumb, 18 bytes, Stack size 0 bytes, stm32f10x_dma.o(i.DMA_ITConfig))

[Called By]

- >> DebugUart_Init
- >> ST7789_GPIO_Init

DMA_Init (Thumb, 60 bytes, Stack size 8 bytes, stm32f10x_dma.o(i.DMA_Init))

[Stack]

- Max Depth = 8
- Call Chain = DMA_Init

[Called By]

- >> DebugUart_Init
- >> ST7789_GPIO_Init

DMA_SetCurrDataCounter (Thumb, 4 bytes, Stack size 0 bytes, stm32f10x_dma.o(i.DMA_SetCurrDataCounter))

[Called By]

- >> DebugUart_KickLocked
- >> ST7789_StartDma

DebugMon_Handler (Thumb, 2 bytes, Stack size 0 bytes, stm32f10x_it.o(i.DebugMon_Handler))
[Address Reference Count : 1]

- startup_stm32f10x_md.o(RESET)

DebugUart_Init (Thumb, 230 bytes, Stack size 72 bytes, debug_uart.o(i.DebugUart_Init))

[Stack]

- Max Depth = 140
- Call Chain = DebugUart_Init ⇒ USART_Init ⇒ RCC_GetClocksFreq

[Calls]

- >> USART_Init
- >> USART_DMACmd
- >> USART_Cmd
- >> RCC_APB2PeriphClockCmd
- >> RCC_AHBPeriphClockCmd
- >> GPIO_Init
- >> DMA_Init
- >> DMA_ITConfig
- >> DMA_DeInit
- >> NVIC_Init

[Called By]

- >> App_Init

DebugUart_Printf (Thumb, 74 bytes, Stack size 200 bytes, debug_uart.o(i.DebugUart_Printf))

[Stack]

- Max Depth = 224
- Call Chain = DebugUart_Printf ⇒ DebugUart_PushByte ⇒ DebugUart_KickLocked

[Calls]

- >> DebugUart_PushByte
- >> vsnprintf

[Called By]

- >> App_ReportTask

DebugUart_Write (Thumb, 32 bytes, Stack size 16 bytes, debug_uart.o(i.DebugUart_Write))

[Stack]

- Max Depth = 40
- Call Chain = DebugUart_Write ⇒ DebugUart_PushByte ⇒ DebugUart_KickLocked

[Calls]

- >> DebugUart_PushByte

[Called By]

- >> App_Init

DisplayUi_Init (Thumb, 26 bytes, Stack size 8 bytes, display_ui.o(i.DisplayUi_Init))

[Stack]

- Max Depth = 144
- Call Chain = DisplayUi_Init ⇒ ST7789_Init ⇒ ST7789_GPIO_Init ⇒ GPIO_Init

[Calls]

- >> ST7789_Init
- >> ResetDrawCaches

[Called By]

- >> App_Init

DisplayUi_Task (Thumb, 322 bytes, Stack size 24 bytes, display_ui.o(i.DisplayUi_Task))

[Stack]

- Max Depth = 272
- Call Chain = DisplayUi_Task ⇒ DrawStatusBar ⇒ DrawCachedString ⇒ ST7789_DrawChar ⇒ ST7789_FillRect ⇒ ST7789_SetAddressWindow ⇒ ST7789_WriteData16 ⇒ ST7789_WriteByte ⇒ SpiBusy

[Calls]

- >> ResetDrawCaches
- >> DrawWaitingInfo
- >> DrawWaitingFrame
- >> DrawStatusBar
- >> DrawStaticFrame
- >> DrawRelayCard
- >> DrawMainTemperature
- >> DrawInfoRow
- >> DrawCurve
- >> ST7789_Task
- >> __aeabi_memcpy4

[Called By]

- >> main

ESP01S_Init (Thumb, 8 bytes, Stack size 8 bytes, esp01s.o(i.ESP01S_Init))

[Stack]

- Max Depth = 108
- Call Chain = ESP01S_Init ⇒ EspUart_Init ⇒ USART_Init ⇒ RCC_GetClocksFreq

[Calls]

- >> EspUart_Init

[Called By]

- >> App_Init

ESP01S_PopCommand (Thumb, 36 bytes, Stack size 8 bytes, esp01s.o(i.ESP01S_PopCommand))

[Stack]

- Max Depth = 8
- Call Chain = ESP01S_PopCommand

[Calls]

- >> __aeabi_memcpy4

[Called By]

- >> App_CommandTask

ESP01S_SendAck (Thumb, 60 bytes, Stack size 120 bytes, esp01s.o(i.ESP01S_SendAck))

[Stack]

- Max Depth = 156
- Call Chain = ESP01S_SendAck ⇒ EspUart_SendString ⇒ USART_ITConfig

[Calls]

- >> EspUart_SendString
- >> __2snprintf

[Called By]

- >> App_ProcessCommand

ESP01S_SendState (Thumb, 168 bytes, Stack size 136 bytes, esp01s.o(i.ESP01S_SendState))

[Stack]

- Max Depth = 172
- Call Chain = ESP01S_SendState ⇒ EspUart_SendString ⇒ USART_ITConfig

[Calls]

- >> EspUart_SendString
- >> AppMode_ToText
- >> __2snprintf

[Called By]

- >> App_ReportTask

ESP01S_Task (Thumb, 130 bytes, Stack size 176 bytes, esp01s.o(i.ESP01S_Task))

[Stack]

- Max Depth = 312
- Call Chain = ESP01S_Task ⇒ HandleLine ⇒ atoi ⇒ strtol ⇒ _strtoul

[Calls]

- >> EspUart_GetLine
- >> HandleLine
- >> strncmp
- >> strncpy

[Called By]

- >> main

EspUart_GetLine (Thumb, 114 bytes, Stack size 12 bytes, esp_uart.o(i.EspUart_GetLine))

[Stack]

- Max Depth = 12
- Call Chain = EspUart_GetLine

[Called By]

- >> ESP01S_Task

EspUart_Init (Thumb, 158 bytes, Stack size 32 bytes, esp_uart.o(i.EspUart_Init))

[Stack]

- Max Depth = 100
- Call Chain = EspUart_Init ⇒ USART_Init ⇒ RCC_GetClocksFreq

[Calls]

- >> USART_ITConfig
- >> USART_Init
- >> USART_Cmd
- >> RCC_APB2PeriphClockCmd
- >> GPIO_Init
- >> RCC_APB1PeriphClockCmd
- >> NVIC_Init

[Called By]

- >> ESP01S_Init

EspUart_SendString (Thumb, 74 bytes, Stack size 16 bytes, esp_uart.o(i.EspUart_SendString))

[Stack]

- Max Depth = 36
- Call Chain = EspUart_SendString ⇒ USART_ITConfig

[Calls]

- >> USART_ITConfig

[Called By]

- >> ESP01S_SendState
- >> ESP01S_SendAck

GPIO_Init (Thumb, 278 bytes, Stack size 24 bytes, stm32f10x_gpio.o(i.GPIO_Init))

[Stack]

- Max Depth = 24
- Call Chain = GPIO_Init

[Called By]

- >> EspUart_Init
- >> Relay_Init
- >> Presence_Init
- >> DebugUart_Init
- >> BoardIo_Init
- >> ST7789_GPIO_Init
- >> LowerUart_Init

GPIO_ReadInputDataBit (Thumb, 18 bytes, Stack size 0 bytes, stm32f10x_gpio.o(i.GPIO_ReadInputDataBit))

[Called By]

- >> Presence_ReadRaw

GPIO_ResetBits (Thumb, 4 bytes, Stack size 0 bytes, stm32f10x_gpio.o(i.GPIO_ResetBits))

[Called By]

- >> ST7789_Init
- >> Presence_Init
- >> BoardIo_Task
- >> BoardIo_Init
- >> ST7789_WriteCommand
- >> Relay_Set

GPIO_SetBits (Thumb, 4 bytes, Stack size 0 bytes, stm32f10x_gpio.o(i.GPIO_SetBits))

[Called By]

- >> ST7789_Init
- >> BoardIo_Task
- >> BoardIo_Init
- >> ST7789_WriteData8
- >> ST7789_WriteData16
- >> ST7789_StartDma
- >> ST7789_GPIO_Init
- >> Relay_Set

HardFault_Handler (Thumb, 4 bytes, Stack size 0 bytes, stm32f10x_it.o(i.HardFault_Handler))
[Address Reference Count : 1]

- startup_stm32f10x_md.o(RESET)

LowerLink_Init (Thumb, 38 bytes, Stack size 8 bytes, lower_link.o(i.LowerLink_Init))

[Stack]

- Max Depth = 108
- Call Chain = LowerLink_Init ⇒ LowerUart_Init ⇒ USART_Init ⇒ RCC_GetClocksFreq

[Calls]

- >> LowerUart_Init

[Called By]

- >> App_Init

LowerLink_Task (Thumb, 328 bytes, Stack size 88 bytes, lower_link.o(i.LowerLink_Task))

[Stack]

- Max Depth = 232
- Call Chain = LowerLink_Task ⇒ ParseStatusFrame ⇒ ParseNumberField ⇒ ParseNumber ⇒ strtol ⇒ _strtoul

[Calls]

- >> SetLowerRxActivityError
- >> SetLowerError
- >> ParseStatusFrame
- >> ApplyStatusFrame
- >> LowerUart_GetRxByteCount
- >> LowerUart_GetParityErrorCount
- >> LowerUart_GetOverrunCount
- >> LowerUart_GetOverflowCount
- >> LowerUart_GetNoiseErrorCount
- >> LowerUart_GetLine
- >> LowerUart_GetFrameErrorCount

[Called By]

- >> main

LowerUart_GetFrameErrorCount (Thumb, 10 bytes, Stack size 0 bytes, lower_uart.o(i.LowerUart_GetFrameErrorCount))

[Called By]

- >> LowerLink_Task

LowerUart_GetLine (Thumb, 106 bytes, Stack size 8 bytes, lower_uart.o(i.LowerUart_GetLine))

[Stack]

- Max Depth = 8
- Call Chain = LowerUart_GetLine

[Called By]

- >> LowerLink_Task

LowerUart_GetNoiseErrorCount (Thumb, 10 bytes, Stack size 0 bytes, lower_uart.o(i.LowerUart_GetNoiseErrorCount))

[Called By]

- >> LowerLink_Task

LowerUart_GetOverflowCount (Thumb, 10 bytes, Stack size 0 bytes, lower_uart.o(i.LowerUart_GetOverflowCount))

[Called By]

- >> LowerLink_Task

LowerUart_GetOverrunCount (Thumb, 10 bytes, Stack size 0 bytes, lower_uart.o(i.LowerUart_GetOverrunCount))

[Called By]

- >> LowerLink_Task

LowerUart_GetParityErrorCount (Thumb, 10 bytes, Stack size 0 bytes, lower_uart.o(i.LowerUart_GetParityErrorCount))

[Called By]

- >> LowerLink_Task

LowerUart_GetRecentHex (Thumb, 156 bytes, Stack size 28 bytes, lower_uart.o(i.LowerUart_GetRecentHex))

[Stack]

- Max Depth = 28
- Call Chain = LowerUart_GetRecentHex

[Called By]

- >> SetLowerRxActivityError

LowerUart_GetRxByteCount (Thumb, 10 bytes, Stack size 0 bytes, lower_uart.o(i.LowerUart_GetRxByteCount))

[Called By]

- >> LowerLink_Task

LowerUart_Init (Thumb, 138 bytes, Stack size 32 bytes, lower_uart.o(i.LowerUart_Init))

[Stack]

- Max Depth = 100
- Call Chain = LowerUart_Init ⇒ USART_Init ⇒ RCC_GetClocksFreq

[Calls]

- >> USART_ITConfig
- >> USART_Init
- >> USART_Cmd
- >> RCC_APB2PeriphClockCmd
- >> GPIO_Init
- >> RCC_APB1PeriphClockCmd
- >> NVIC_Init

[Called By]

- >> LowerLink_Init

MemManage_Handler (Thumb, 4 bytes, Stack size 0 bytes, stm32f10x_it.o(i.MemManage_Handler))
[Address Reference Count : 1]

- startup_stm32f10x_md.o(RESET)

NMI_Handler (Thumb, 2 bytes, Stack size 0 bytes, stm32f10x_it.o(i.NMI_Handler))
[Address Reference Count : 1]

- startup_stm32f10x_md.o(RESET)

NVIC_Init (Thumb, 100 bytes, Stack size 16 bytes, misc.o(i.NVIC_Init))

[Stack]

- Max Depth = 16
- Call Chain = NVIC_Init

[Called By]

- >> EspUart_Init
- >> Timer_Init1ms
- >> DebugUart_Init
- >> ST7789_GPIO_Init
- >> LowerUart_Init

NVIC_PriorityGroupConfig (Thumb, 10 bytes, Stack size 0 bytes, misc.o(i.NVIC_PriorityGroupConfig))

[Called By]

- >> App_Init

PendSV_Handler (Thumb, 2 bytes, Stack size 0 bytes, stm32f10x_it.o(i.PendSV_Handler))
[Address Reference Count : 1]

- startup_stm32f10x_md.o(RESET)

Presence_Init (Thumb, 76 bytes, Stack size 8 bytes, presence.o(i.Presence_Init))

[Stack]

- Max Depth = 32
- Call Chain = Presence_Init ⇒ GPIO_Init

[Calls]

- >> RCC_APB2PeriphClockCmd
- >> GPIO_Init
- >> GPIO_ResetBits

[Called By]

- >> App_Init

Presence_IsDetected (Thumb, 6 bytes, Stack size 0 bytes, presence.o(i.Presence_IsDetected))

[Called By]

- >> App_PresenceTask

Presence_IsEnabled (Thumb, 4 bytes, Stack size 0 bytes, presence.o(i.Presence_IsEnabled))

[Called By]

- >> App_Init

Presence_ReadRaw (Thumb, 20 bytes, Stack size 8 bytes, presence.o(i.Presence_ReadRaw))

[Stack]

- Max Depth = 8
- Call Chain = Presence_ReadRaw

[Calls]

- >> GPIO_ReadInputDataBit

[Called By]

- >> Presence_Task

Presence_Task (Thumb, 142 bytes, Stack size 16 bytes, presence.o(i.Presence_Task))

[Stack]

- Max Depth = 24
- Call Chain = Presence_Task ⇒ Presence_ReadRaw

[Calls]

- >> Presence_ReadRaw
- >> Presence_ConvertRaw

[Called By]

- >> App_PresenceTask

RCC_AHBPeriphClockCmd (Thumb, 26 bytes, Stack size 0 bytes, stm32f10x_rcc.o(i.RCC_AHBPeriphClockCmd))

[Called By]

- >> DebugUart_Init
- >> ST7789_GPIO_Init

RCC_APB1PeriphClockCmd (Thumb, 26 bytes, Stack size 0 bytes, stm32f10x_rcc.o(i.RCC_APB1PeriphClockCmd))

[Called By]

- >> EspUart_Init
- >> Timer_Init1ms
- >> LowerUart_Init

RCC_APB2PeriphClockCmd (Thumb, 26 bytes, Stack size 0 bytes, stm32f10x_rcc.o(i.RCC_APB2PeriphClockCmd))

[Called By]

- >> EspUart_Init
- >> Relay_Init
- >> Presence_Init
- >> DebugUart_Init
- >> BoardIo_Init
- >> ST7789_GPIO_Init
- >> LowerUart_Init

RCC_GetClocksFreq (Thumb, 192 bytes, Stack size 12 bytes, stm32f10x_rcc.o(i.RCC_GetClocksFreq))

[Stack]

- Max Depth = 12
- Call Chain = RCC_GetClocksFreq

[Called By]

- >> USART_Init

Relay_AllOff (Thumb, 28 bytes, Stack size 8 bytes, relay.o(i.Relay_AllOff))

[Stack]

- Max Depth = 24
- Call Chain = Relay_AllOff ⇒ Relay_Set

[Calls]

- >> Relay_Set

[Called By]

- >> Relay_Init
- >> App_Init

Relay_ApplyAll (Thumb, 30 bytes, Stack size 8 bytes, relay.o(i.Relay_ApplyAll))

[Stack]

- Max Depth = 24
- Call Chain = Relay_ApplyAll ⇒ Relay_Set

[Calls]

- >> Relay_Set

[Called By]

- >> App_RelayTask

Relay_Init (Thumb, 44 bytes, Stack size 8 bytes, relay.o(i.Relay_Init))

[Stack]

- Max Depth = 32
- Call Chain = Relay_Init ⇒ GPIO_Init

[Calls]

- >> RCC_APB2PeriphClockCmd
- >> GPIO_Init
- >> Relay_AllOff

[Called By]

- >> App_Init

Relay_Set (Thumb, 58 bytes, Stack size 16 bytes, relay.o(i.Relay_Set))

[Stack]

- Max Depth = 16
- Call Chain = Relay_Set

[Calls]

- >> Relay_Pin
- >> GPIO_SetBits
- >> GPIO_ResetBits

[Called By]

- >> Relay_ApplyAll
- >> Relay_AllOff

SPI_Cmd (Thumb, 24 bytes, Stack size 0 bytes, stm32f10x_spi.o(i.SPI_Cmd))

[Called By]

- >> ST7789_GPIO_Init

SPI_I2S_DMACmd (Thumb, 18 bytes, Stack size 0 bytes, stm32f10x_spi.o(i.SPI_I2S_DMACmd))

[Called By]

- >> ST7789_GPIO_Init

SPI_I2S_GetFlagStatus (Thumb, 18 bytes, Stack size 0 bytes, stm32f10x_spi.o(i.SPI_I2S_GetFlagStatus))

[Called By]

- >> SpiBusy
- >> ST7789_WriteByte

SPI_I2S_SendData (Thumb, 4 bytes, Stack size 0 bytes, stm32f10x_spi.o(i.SPI_I2S_SendData))

[Called By]

- >> ST7789_WriteByte

SPI_Init (Thumb, 60 bytes, Stack size 8 bytes, stm32f10x_spi.o(i.SPI_Init))

[Stack]

- Max Depth = 8
- Call Chain = SPI_Init

[Called By]

- >> ST7789_GPIO_Init

ST7789_DrawChar (Thumb, 152 bytes, Stack size 48 bytes, st7789.o(i.ST7789_DrawChar))

[Stack]

- Max Depth = 136
- Call Chain = ST7789_DrawChar ⇒ ST7789_FillRect ⇒ ST7789_SetAddressWindow ⇒ ST7789_WriteData16 ⇒ ST7789_WriteByte ⇒ SpiBusy

[Calls]

- >> ST7789_FillRect

[Called By]

- >> ST7789_DrawString
- >> DrawDegreeC
- >> DrawCachedString

ST7789_DrawLine (Thumb, 170 bytes, Stack size 48 bytes, st7789.o(i.ST7789_DrawLine))

[Stack]

- Max Depth = 120
- Call Chain = ST7789_DrawLine ⇒ ST7789_DrawPixel ⇒ ST7789_SetAddressWindow ⇒ ST7789_WriteData16 ⇒ ST7789_WriteByte ⇒ SpiBusy

[Calls]

- >> ST7789_DrawPixel

[Called By]

- >> DrawWaitingFrame
- >> DrawThickLine
- >> DrawStaticFrame
- >> DrawRect
- >> DrawDashedTarget
- >> DrawCurve
- >> DrawChartGrid

ST7789_DrawPixel (Thumb, 44 bytes, Stack size 16 bytes, st7789.o(i.ST7789_DrawPixel))

[Stack]

- Max Depth = 72
- Call Chain = ST7789_DrawPixel ⇒ ST7789_SetAddressWindow ⇒ ST7789_WriteData16 ⇒ ST7789_WriteByte ⇒ SpiBusy

[Calls]

- >> ST7789_WriteData16
- >> ST7789_WaitReady
- >> ST7789_SetAddressWindow

[Called By]

- >> DrawGlyph16
- >> ST7789_DrawLine

ST7789_DrawString (Thumb, 74 bytes, Stack size 40 bytes, st7789.o(i.ST7789_DrawString))

[Stack]

- Max Depth = 176
- Call Chain = ST7789_DrawString ⇒ ST7789_DrawChar ⇒ ST7789_FillRect ⇒ ST7789_SetAddressWindow ⇒ ST7789_WriteData16 ⇒ ST7789_WriteByte ⇒ SpiBusy

[Calls]

- >> ST7789_DrawChar

[Called By]

- >> DrawWaitingInfo
- >> DrawWaitingFrame
- >> DrawStaticFrame
- >> DrawRelayCard
- >> DrawChartGrid

ST7789_FillRect (Thumb, 100 bytes, Stack size 32 bytes, st7789.o(i.ST7789_FillRect))

[Stack]

- Max Depth = 88
- Call Chain = ST7789_FillRect ⇒ ST7789_SetAddressWindow ⇒ ST7789_WriteData16 ⇒ ST7789_WriteByte ⇒ SpiBusy

[Calls]

- >> ST7789_WriteData16
- >> ST7789_WaitReady
- >> ST7789_SetAddressWindow

[Called By]

- >> ST7789_FillScreen
- >> ST7789_DrawChar
- >> DrawWaitingInfo
- >> DrawWaitingFrame
- >> DrawStatusBar
- >> DrawStaticFrame
- >> DrawRelayCard
- >> DrawInfoRow
- >> DrawDegreeC
- >> DrawCurve
- >> DrawChartGrid
- >> DrawBigDot
- >> DrawBigDigit
- >> BigSegRect

ST7789_FillScreen (Thumb, 20 bytes, Stack size 16 bytes, st7789.o(i.ST7789_FillScreen))

[Stack]

- Max Depth = 104
- Call Chain = ST7789_FillScreen ⇒ ST7789_FillRect ⇒ ST7789_SetAddressWindow ⇒ ST7789_WriteData16 ⇒ ST7789_WriteByte ⇒ SpiBusy

[Calls]

- >> ST7789_FillRect

[Called By]

- >> ST7789_Init
- >> DrawWaitingFrame
- >> DrawStaticFrame

ST7789_Init (Thumb, 228 bytes, Stack size 8 bytes, st7789.o(i.ST7789_Init))

[Stack]

- Max Depth = 136
- Call Chain = ST7789_Init ⇒ ST7789_GPIO_Init ⇒ GPIO_Init

[Calls]

- >> delay_ms
- >> ST7789_FillScreen
- >> ST7789_WriteData8
- >> ST7789_WriteCommand
- >> ST7789_GPIO_Init
- >> GPIO_SetBits
- >> GPIO_ResetBits

[Called By]

- >> DisplayUi_Init

ST7789_IsBusy (Thumb, 28 bytes, Stack size 8 bytes, st7789.o(i.ST7789_IsBusy))

[Stack]

- Max Depth = 16
- Call Chain = ST7789_IsBusy ⇒ SpiBusy

[Calls]

- >> SpiBusy

[Called By]

- >> ST7789_WaitReady

ST7789_SetBacklight (Thumb, 32 bytes, Stack size 16 bytes, st7789.o(i.ST7789_SetBacklight))

[Stack]

- Max Depth = 16
- Call Chain = ST7789_SetBacklight

[Calls]

- >> TIM_SetCompare1

[Called By]

- >> ST7789_GPIO_Init

ST7789_Task (Thumb, 64 bytes, Stack size 8 bytes, st7789.o(i.ST7789_Task))

[Stack]

- Max Depth = 24
- Call Chain = ST7789_Task ⇒ ST7789_StartDma ⇒ SpiBusy

[Calls]

- >> SpiBusy
- >> ST7789_StartDma

[Called By]

- >> DisplayUi_Task
- >> main
- >> ST7789_WaitReady

SVC_Handler (Thumb, 2 bytes, Stack size 0 bytes, stm32f10x_it.o(i.SVC_Handler))
[Address Reference Count : 1]

- startup_stm32f10x_md.o(RESET)

SysTick_CLKSourceConfig (Thumb, 40 bytes, Stack size 0 bytes, misc.o(i.SysTick_CLKSourceConfig))

[Called By]

- >> delay_init

SysTick_Handler (Thumb, 2 bytes, Stack size 0 bytes, stm32f10x_it.o(i.SysTick_Handler))
[Address Reference Count : 1]

- startup_stm32f10x_md.o(RESET)

SystemInit (Thumb, 78 bytes, Stack size 8 bytes, system_stm32f10x.o(i.SystemInit))

[Stack]

- Max Depth = 28
- Call Chain = SystemInit ⇒ SetSysClock ⇒ SetSysClockTo72

[Calls]

- >> SetSysClock

[Called By]

- >> main

TIM3_IRQHandler (Thumb, 32 bytes, Stack size 8 bytes, timer.o(i.TIM3_IRQHandler))

[Stack]

- Max Depth = 20
- Call Chain = TIM3_IRQHandler ⇒ TIM_GetITStatus

[Calls]

- >> TIM_GetITStatus
- >> TIM_ClearITPendingBit

[Address Reference Count : 1]

- startup_stm32f10x_md.o(RESET)

TIM_ARRPreloadConfig (Thumb, 24 bytes, Stack size 0 bytes, stm32f10x_tim.o(i.TIM_ARRPreloadConfig))

[Called By]

- >> ST7789_GPIO_Init

TIM_ClearFlag (Thumb, 6 bytes, Stack size 0 bytes, stm32f10x_tim.o(i.TIM_ClearFlag))

[Called By]

- >> Timer_Init1ms

TIM_ClearITPendingBit (Thumb, 6 bytes, Stack size 0 bytes, stm32f10x_tim.o(i.TIM_ClearITPendingBit))

[Called By]

- >> TIM3_IRQHandler

TIM_Cmd (Thumb, 24 bytes, Stack size 0 bytes, stm32f10x_tim.o(i.TIM_Cmd))

[Called By]

- >> Timer_Init1ms
- >> ST7789_GPIO_Init

TIM_CtrlPWMOutputs (Thumb, 30 bytes, Stack size 0 bytes, stm32f10x_tim.o(i.TIM_CtrlPWMOutputs))

[Called By]

- >> ST7789_GPIO_Init

TIM_GetITStatus (Thumb, 34 bytes, Stack size 12 bytes, stm32f10x_tim.o(i.TIM_GetITStatus))

[Stack]

- Max Depth = 12
- Call Chain = TIM_GetITStatus

[Called By]

- >> TIM3_IRQHandler

TIM_ITConfig (Thumb, 18 bytes, Stack size 0 bytes, stm32f10x_tim.o(i.TIM_ITConfig))

[Called By]

- >> Timer_Init1ms

TIM_OC1Init (Thumb, 132 bytes, Stack size 16 bytes, stm32f10x_tim.o(i.TIM_OC1Init))

[Stack]

- Max Depth = 16
- Call Chain = TIM_OC1Init

[Called By]

- >> ST7789_GPIO_Init

TIM_OC1PreloadConfig (Thumb, 18 bytes, Stack size 0 bytes, stm32f10x_tim.o(i.TIM_OC1PreloadConfig))

[Called By]

- >> ST7789_GPIO_Init

TIM_SetCompare1 (Thumb, 4 bytes, Stack size 0 bytes, stm32f10x_tim.o(i.TIM_SetCompare1))

[Called By]

- >> ST7789_SetBacklight

TIM_TimeBaseInit (Thumb, 122 bytes, Stack size 0 bytes, stm32f10x_tim.o(i.TIM_TimeBaseInit))

[Called By]

- >> Timer_Init1ms
- >> ST7789_GPIO_Init

Timer_GetMs (Thumb, 10 bytes, Stack size 0 bytes, timer.o(i.Timer_GetMs))

[Called By]

- >> main

Timer_Init1ms (Thumb, 104 bytes, Stack size 24 bytes, timer.o(i.Timer_Init1ms))

[Stack]

- Max Depth = 40
- Call Chain = Timer_Init1ms ⇒ NVIC_Init

[Calls]

- >> TIM_TimeBaseInit
- >> TIM_ITConfig
- >> TIM_Cmd
- >> TIM_ClearFlag
- >> RCC_APB1PeriphClockCmd
- >> NVIC_Init

[Called By]

- >> App_Init

USART2_IRQHandler (Thumb, 184 bytes, Stack size 8 bytes, esp_uart.o(i.USART2_IRQHandler))

[Stack]

- Max Depth = 28
- Call Chain = USART2_IRQHandler ⇒ USART_ITConfig

[Calls]

- >> USART_ReceiveData
- >> USART_ITConfig
- >> USART_GetITStatus
- >> USART_ClearITPendingBit
- >> QueuePushFromIrq
- >> USART_SendData

[Address Reference Count : 1]

- startup_stm32f10x_md.o(RESET)

USART3_IRQHandler (Thumb, 304 bytes, Stack size 24 bytes, lower_uart.o(i.USART3_IRQHandler))

[Stack]

- Max Depth = 32
- Call Chain = USART3_IRQHandler ⇒ QueuePushFromIrq

[Calls]

- >> QueuePushFromIrq
- >> IsFrameChar

[Address Reference Count : 1]

- startup_stm32f10x_md.o(RESET)

USART_ClearITPendingBit (Thumb, 30 bytes, Stack size 8 bytes, stm32f10x_usart.o(i.USART_ClearITPendingBit))

[Stack]

- Max Depth = 8
- Call Chain = USART_ClearITPendingBit

[Called By]

- >> USART2_IRQHandler

USART_Cmd (Thumb, 24 bytes, Stack size 0 bytes, stm32f10x_usart.o(i.USART_Cmd))

[Called By]

- >> EspUart_Init
- >> DebugUart_Init
- >> LowerUart_Init

USART_DMACmd (Thumb, 18 bytes, Stack size 0 bytes, stm32f10x_usart.o(i.USART_DMACmd))

[Called By]

- >> DebugUart_Init

USART_GetITStatus (Thumb, 84 bytes, Stack size 16 bytes, stm32f10x_usart.o(i.USART_GetITStatus))

[Stack]

- Max Depth = 16
- Call Chain = USART_GetITStatus

[Called By]

- >> USART2_IRQHandler

USART_ITConfig (Thumb, 74 bytes, Stack size 20 bytes, stm32f10x_usart.o(i.USART_ITConfig))

[Stack]

- Max Depth = 20
- Call Chain = USART_ITConfig

[Called By]

- >> USART2_IRQHandler
- >> EspUart_SendString
- >> EspUart_Init
- >> LowerUart_Init

USART_Init (Thumb, 210 bytes, Stack size 56 bytes, stm32f10x_usart.o(i.USART_Init))

[Stack]

- Max Depth = 68
- Call Chain = USART_Init ⇒ RCC_GetClocksFreq

[Calls]

- >> RCC_GetClocksFreq

[Called By]

- >> EspUart_Init
- >> DebugUart_Init
- >> LowerUart_Init

USART_ReceiveData (Thumb, 10 bytes, Stack size 0 bytes, stm32f10x_usart.o(i.USART_ReceiveData))

[Called By]

- >> USART2_IRQHandler

USART_SendData (Thumb, 8 bytes, Stack size 0 bytes, stm32f10x_usart.o(i.USART_SendData))

[Called By]

- >> USART2_IRQHandler

UiAssets_DrawText16 (Thumb, 68 bytes, Stack size 40 bytes, ui_assets.o(i.UiAssets_DrawText16))

[Stack]

- Max Depth = 152
- Call Chain = UiAssets_DrawText16 ⇒ DrawGlyph16 ⇒ ST7789_DrawPixel ⇒ ST7789_SetAddressWindow ⇒ ST7789_WriteData16 ⇒ ST7789_WriteByte ⇒ SpiBusy

[Calls]

- >> GetPhrase
- >> DrawGlyph16

[Called By]

- >> DrawStatusBar
- >> DrawRelayCard
- >> DrawInfoRow

UsageFault_Handler (Thumb, 4 bytes, Stack size 0 bytes, stm32f10x_it.o(i.UsageFault_Handler))
[Address Reference Count : 1]

- startup_stm32f10x_md.o(RESET)

__0snprintf (Thumb, 44 bytes, Stack size 32 bytes, printfa.o(i.__0snprintf), UNUSED)

[Calls]

- >> _printf_core

__1snprintf (Thumb, 0 bytes, Stack size 32 bytes, printfa.o(i.__0snprintf), UNUSED)

__2snprintf (Thumb, 0 bytes, Stack size 32 bytes, printfa.o(i.__0snprintf))

[Stack]

- Max Depth = 32
- Call Chain = __2snprintf

[Called By]

- >> DrawWaitingInfo
- >> DrawStatusBar
- >> DrawInfoRow
- >> ESP01S_SendState
- >> ESP01S_SendAck

__c89snprintf (Thumb, 0 bytes, Stack size 32 bytes, printfa.o(i.__0snprintf), UNUSED)

snprintf (Thumb, 0 bytes, Stack size 32 bytes, printfa.o(i.__0snprintf), UNUSED)

__0vsnprintf (Thumb, 40 bytes, Stack size 24 bytes, printfa.o(i.__0vsnprintf), UNUSED)

[Calls]

- >> _printf_core

__1vsnprintf (Thumb, 0 bytes, Stack size 24 bytes, printfa.o(i.__0vsnprintf), UNUSED)

__2vsnprintf (Thumb, 0 bytes, Stack size 24 bytes, printfa.o(i.__0vsnprintf), UNUSED)

__c89vsnprintf (Thumb, 0 bytes, Stack size 24 bytes, printfa.o(i.__0vsnprintf), UNUSED)

vsnprintf (Thumb, 0 bytes, Stack size 24 bytes, printfa.o(i.__0vsnprintf))

[Stack]

- Max Depth = 24
- Call Chain = vsnprintf

[Called By]

- >> DebugUart_Printf

__aeabi_errno_addr (Thumb, 4 bytes, Stack size 0 bytes, errno.o(i.__aeabi_errno_addr))

[Called By]

- >> _strtoul
- >> atoi
- >> strtol

__rt_errno_addr (Thumb, 0 bytes, Stack size 0 bytes, errno.o(i.__aeabi_errno_addr), UNUSED)

__scatterload_copy (Thumb, 14 bytes, Stack size unknown bytes, handlers.o(i.__scatterload_copy), UNUSED)

__scatterload_null (Thumb, 2 bytes, Stack size unknown bytes, handlers.o(i.__scatterload_null), UNUSED)

__scatterload_zeroinit (Thumb, 14 bytes, Stack size unknown bytes, handlers.o(i.__scatterload_zeroinit), UNUSED)

delay_init (Thumb, 52 bytes, Stack size 8 bytes, delay.o(i.delay_init))

[Stack]

- Max Depth = 8
- Call Chain = delay_init

[Calls]

- >> SysTick_CLKSourceConfig

[Called By]

- >> main

delay_ms (Thumb, 56 bytes, Stack size 0 bytes, delay.o(i.delay_ms))

[Called By]

- >> ST7789_Init

main (Thumb, 94 bytes, Stack size 0 bytes, main.o(i.main))

[Stack]

- Max Depth = 328
- Call Chain = main ⇒ App_ReportTask ⇒ DebugUart_Printf ⇒ DebugUart_PushByte ⇒ DebugUart_KickLocked

[Calls]

- >> delay_init
- >> Timer_GetMs
- >> SystemInit
- >> ST7789_Task
- >> LowerLink_Task
- >> ESP01S_Task
- >> DisplayUi_Task
- >> BoardIo_Task
- >> App_TempDemoTask
- >> App_ReportTask
- >> App_RelayTask
- >> App_PresenceTask
- >> App_Init
- >> App_CommandTask
- >> App_AutoControlTask

[Address Reference Count : 1]

- entry9a.o(.ARM.Collect$$$$0000000B)

### Local Symbols

App_AutoControlTask (Thumb, 52 bytes, Stack size 0 bytes, main.o(i.App_AutoControlTask))

[Called By]

- >> main

App_CommandTask (Thumb, 36 bytes, Stack size 48 bytes, main.o(i.App_CommandTask))

[Stack]

- Max Depth = 220
- Call Chain = App_CommandTask ⇒ App_ProcessCommand ⇒ ESP01S_SendAck ⇒ EspUart_SendString ⇒ USART_ITConfig

[Calls]

- >> ESP01S_PopCommand
- >> App_ProcessCommand

[Called By]

- >> main

App_Init (Thumb, 70 bytes, Stack size 8 bytes, main.o(i.App_Init))

[Stack]

- Max Depth = 152
- Call Chain = App_Init ⇒ DisplayUi_Init ⇒ ST7789_Init ⇒ ST7789_GPIO_Init ⇒ GPIO_Init

[Calls]

- >> Timer_Init1ms
- >> Relay_Init
- >> Relay_AllOff
- >> Presence_IsEnabled
- >> Presence_Init
- >> NVIC_PriorityGroupConfig
- >> LowerLink_Init
- >> ESP01S_Init
- >> DisplayUi_Init
- >> DebugUart_Write
- >> DebugUart_Init
- >> BoardIo_Init
- >> AppState_Init

[Called By]

- >> main

App_PresenceTask (Thumb, 46 bytes, Stack size 8 bytes, main.o(i.App_PresenceTask))

[Stack]

- Max Depth = 32
- Call Chain = App_PresenceTask ⇒ Presence_Task ⇒ Presence_ReadRaw

[Calls]

- >> Presence_Task
- >> Presence_IsDetected

[Called By]

- >> main

App_ProcessCommand (Thumb, 244 bytes, Stack size 16 bytes, main.o(i.App_ProcessCommand))

[Stack]

- Max Depth = 172
- Call Chain = App_ProcessCommand ⇒ ESP01S_SendAck ⇒ EspUart_SendString ⇒ USART_ITConfig

[Calls]

- >> ESP01S_SendAck
- >> App_SetLoad
- >> strcmp

[Called By]

- >> App_CommandTask

App_RelayTask (Thumb, 30 bytes, Stack size 8 bytes, main.o(i.App_RelayTask))

[Stack]

- Max Depth = 32
- Call Chain = App_RelayTask ⇒ Relay_ApplyAll ⇒ Relay_Set

[Calls]

- >> Relay_ApplyAll

[Called By]

- >> main

App_ReportTask (Thumb, 208 bytes, Stack size 104 bytes, main.o(i.App_ReportTask))

[Stack]

- Max Depth = 328
- Call Chain = App_ReportTask ⇒ DebugUart_Printf ⇒ DebugUart_PushByte ⇒ DebugUart_KickLocked

[Calls]

- >> ESP01S_SendState
- >> DebugUart_Printf
- >> AppMode_ToText

[Called By]

- >> main

App_SetLoad (Thumb, 22 bytes, Stack size 0 bytes, main.o(i.App_SetLoad))

[Called By]

- >> App_ProcessCommand

App_TempDemoTask (Thumb, 2 bytes, Stack size 0 bytes, main.o(i.App_TempDemoTask))

[Called By]

- >> main

SetSysClock (Thumb, 8 bytes, Stack size 8 bytes, system_stm32f10x.o(i.SetSysClock))

[Stack]

- Max Depth = 20
- Call Chain = SetSysClock ⇒ SetSysClockTo72

[Calls]

- >> SetSysClockTo72

[Called By]

- >> SystemInit

SetSysClockTo72 (Thumb, 214 bytes, Stack size 12 bytes, system_stm32f10x.o(i.SetSysClockTo72))

[Stack]

- Max Depth = 12
- Call Chain = SetSysClockTo72

[Called By]

- >> SetSysClock

BigDigitX (Thumb, 18 bytes, Stack size 0 bytes, display_ui.o(i.BigDigitX))

[Called By]

- >> DrawBigDigit

BigSegRect (Thumb, 194 bytes, Stack size 40 bytes, display_ui.o(i.BigSegRect))

[Stack]

- Max Depth = 128
- Call Chain = BigSegRect ⇒ ST7789_FillRect ⇒ ST7789_SetAddressWindow ⇒ ST7789_WriteData16 ⇒ ST7789_WriteByte ⇒ SpiBusy

[Calls]

- >> ST7789_FillRect

[Called By]

- >> DrawBigDigit

CalcPowerPercent (Thumb, 32 bytes, Stack size 0 bytes, display_ui.o(i.CalcPowerPercent))

[Called By]

- >> DrawInfoRow

DrawBigDigit (Thumb, 122 bytes, Stack size 32 bytes, display_ui.o(i.DrawBigDigit))

[Stack]

- Max Depth = 160
- Call Chain = DrawBigDigit ⇒ BigSegRect ⇒ ST7789_FillRect ⇒ ST7789_SetAddressWindow ⇒ ST7789_WriteData16 ⇒ ST7789_WriteByte ⇒ SpiBusy

[Calls]

- >> ST7789_FillRect
- >> BigSegRect
- >> BigDigitX
- >> __aeabi_memset

[Called By]

- >> DrawMainTemperature

DrawBigDot (Thumb, 48 bytes, Stack size 16 bytes, display_ui.o(i.DrawBigDot))

[Stack]

- Max Depth = 104
- Call Chain = DrawBigDot ⇒ ST7789_FillRect ⇒ ST7789_SetAddressWindow ⇒ ST7789_WriteData16 ⇒ ST7789_WriteByte ⇒ SpiBusy

[Calls]

- >> ST7789_FillRect

[Called By]

- >> DrawMainTemperature

DrawCachedString (Thumb, 82 bytes, Stack size 48 bytes, display_ui.o(i.DrawCachedString))

[Stack]

- Max Depth = 184
- Call Chain = DrawCachedString ⇒ ST7789_DrawChar ⇒ ST7789_FillRect ⇒ ST7789_SetAddressWindow ⇒ ST7789_WriteData16 ⇒ ST7789_WriteByte ⇒ SpiBusy

[Calls]

- >> ST7789_DrawChar

[Called By]

- >> DrawWaitingInfo
- >> DrawStatusBar
- >> DrawInfoRow

DrawChartGrid (Thumb, 180 bytes, Stack size 24 bytes, display_ui.o(i.DrawChartGrid))

[Stack]

- Max Depth = 200
- Call Chain = DrawChartGrid ⇒ ST7789_DrawString ⇒ ST7789_DrawChar ⇒ ST7789_FillRect ⇒ ST7789_SetAddressWindow ⇒ ST7789_WriteData16 ⇒ ST7789_WriteByte ⇒ SpiBusy

[Calls]

- >> ST7789_FillRect
- >> ST7789_DrawString
- >> ST7789_DrawLine
- >> DrawRect

[Called By]

- >> DrawStaticFrame

DrawCurve (Thumb, 234 bytes, Stack size 40 bytes, display_ui.o(i.DrawCurve))

[Stack]

- Max Depth = 192
- Call Chain = DrawCurve ⇒ DrawThickLine ⇒ ST7789_DrawLine ⇒ ST7789_DrawPixel ⇒ ST7789_SetAddressWindow ⇒ ST7789_WriteData16 ⇒ ST7789_WriteByte ⇒ SpiBusy

[Calls]

- >> ST7789_FillRect
- >> ST7789_DrawLine
- >> TempToY
- >> PushTemp
- >> GetTargetTemp
- >> DrawThickLine
- >> DrawDashedTarget

[Called By]

- >> DisplayUi_Task

DrawDashedTarget (Thumb, 40 bytes, Stack size 16 bytes, display_ui.o(i.DrawDashedTarget))

[Stack]

- Max Depth = 136
- Call Chain = DrawDashedTarget ⇒ ST7789_DrawLine ⇒ ST7789_DrawPixel ⇒ ST7789_SetAddressWindow ⇒ ST7789_WriteData16 ⇒ ST7789_WriteByte ⇒ SpiBusy

[Calls]

- >> ST7789_DrawLine

[Called By]

- >> DrawCurve

DrawDegreeC (Thumb, 118 bytes, Stack size 16 bytes, display_ui.o(i.DrawDegreeC))

[Stack]

- Max Depth = 152
- Call Chain = DrawDegreeC ⇒ ST7789_DrawChar ⇒ ST7789_FillRect ⇒ ST7789_SetAddressWindow ⇒ ST7789_WriteData16 ⇒ ST7789_WriteByte ⇒ SpiBusy

[Calls]

- >> ST7789_FillRect
- >> ST7789_DrawChar

[Called By]

- >> DrawMainTemperature

DrawInfoRow (Thumb, 156 bytes, Stack size 64 bytes, display_ui.o(i.DrawInfoRow))

[Stack]

- Max Depth = 248
- Call Chain = DrawInfoRow ⇒ DrawCachedString ⇒ ST7789_DrawChar ⇒ ST7789_FillRect ⇒ ST7789_SetAddressWindow ⇒ ST7789_WriteData16 ⇒ ST7789_WriteByte ⇒ SpiBusy

[Calls]

- >> UiAssets_DrawText16
- >> ST7789_FillRect
- >> LowerModeText
- >> GetTargetTemp
- >> DrawCachedString
- >> CalcPowerPercent
- >> __2snprintf

[Called By]

- >> DisplayUi_Task

DrawMainTemperature (Thumb, 242 bytes, Stack size 32 bytes, display_ui.o(i.DrawMainTemperature))

[Stack]

- Max Depth = 192
- Call Chain = DrawMainTemperature ⇒ DrawBigDigit ⇒ BigSegRect ⇒ ST7789_FillRect ⇒ ST7789_SetAddressWindow ⇒ ST7789_WriteData16 ⇒ ST7789_WriteByte ⇒ SpiBusy

[Calls]

- >> DrawDegreeC
- >> DrawBigDot
- >> DrawBigDigit

[Called By]

- >> DisplayUi_Task

DrawRect (Thumb, 116 bytes, Stack size 32 bytes, display_ui.o(i.DrawRect))

[Stack]

- Max Depth = 152
- Call Chain = DrawRect ⇒ ST7789_DrawLine ⇒ ST7789_DrawPixel ⇒ ST7789_SetAddressWindow ⇒ ST7789_WriteData16 ⇒ ST7789_WriteByte ⇒ SpiBusy

[Calls]

- >> ST7789_DrawLine

[Called By]

- >> DrawWaitingFrame
- >> DrawStaticFrame
- >> DrawRelayCard
- >> DrawChartGrid

DrawRelayCard (Thumb, 244 bytes, Stack size 40 bytes, display_ui.o(i.DrawRelayCard))

[Stack]

- Max Depth = 216
- Call Chain = DrawRelayCard ⇒ ST7789_DrawString ⇒ ST7789_DrawChar ⇒ ST7789_FillRect ⇒ ST7789_SetAddressWindow ⇒ ST7789_WriteData16 ⇒ ST7789_WriteByte ⇒ SpiBusy

[Calls]

- >> UiAssets_DrawText16
- >> ST7789_FillRect
- >> ST7789_DrawString
- >> DrawRect

[Called By]

- >> DisplayUi_Task

DrawStaticFrame (Thumb, 142 bytes, Stack size 16 bytes, display_ui.o(i.DrawStaticFrame))

[Stack]

- Max Depth = 216
- Call Chain = DrawStaticFrame ⇒ DrawChartGrid ⇒ ST7789_DrawString ⇒ ST7789_DrawChar ⇒ ST7789_FillRect ⇒ ST7789_SetAddressWindow ⇒ ST7789_WriteData16 ⇒ ST7789_WriteByte ⇒ SpiBusy

[Calls]

- >> ST7789_FillScreen
- >> ST7789_FillRect
- >> ST7789_DrawString
- >> ST7789_DrawLine
- >> DrawRect
- >> DrawChartGrid

[Called By]

- >> DisplayUi_Task

DrawStatusBar (Thumb, 282 bytes, Stack size 64 bytes, display_ui.o(i.DrawStatusBar))

[Stack]

- Max Depth = 248
- Call Chain = DrawStatusBar ⇒ DrawCachedString ⇒ ST7789_DrawChar ⇒ ST7789_FillRect ⇒ ST7789_SetAddressWindow ⇒ ST7789_WriteData16 ⇒ ST7789_WriteByte ⇒ SpiBusy

[Calls]

- >> UiAssets_DrawText16
- >> ST7789_FillRect
- >> DrawCachedString
- >> __2snprintf

[Called By]

- >> DisplayUi_Task

DrawThickLine (Thumb, 80 bytes, Stack size 32 bytes, display_ui.o(i.DrawThickLine))

[Stack]

- Max Depth = 152
- Call Chain = DrawThickLine ⇒ ST7789_DrawLine ⇒ ST7789_DrawPixel ⇒ ST7789_SetAddressWindow ⇒ ST7789_WriteData16 ⇒ ST7789_WriteByte ⇒ SpiBusy

[Calls]

- >> ST7789_DrawLine

[Called By]

- >> DrawCurve

DrawWaitingFrame (Thumb, 150 bytes, Stack size 16 bytes, display_ui.o(i.DrawWaitingFrame))

[Stack]

- Max Depth = 192
- Call Chain = DrawWaitingFrame ⇒ ST7789_DrawString ⇒ ST7789_DrawChar ⇒ ST7789_FillRect ⇒ ST7789_SetAddressWindow ⇒ ST7789_WriteData16 ⇒ ST7789_WriteByte ⇒ SpiBusy

[Calls]

- >> ST7789_FillScreen
- >> ST7789_FillRect
- >> ST7789_DrawString
- >> ST7789_DrawLine
- >> DrawRect

[Called By]

- >> DisplayUi_Task

DrawWaitingInfo (Thumb, 312 bytes, Stack size 56 bytes, display_ui.o(i.DrawWaitingInfo))

[Stack]

- Max Depth = 240
- Call Chain = DrawWaitingInfo ⇒ DrawCachedString ⇒ ST7789_DrawChar ⇒ ST7789_FillRect ⇒ ST7789_SetAddressWindow ⇒ ST7789_WriteData16 ⇒ ST7789_WriteByte ⇒ SpiBusy

[Calls]

- >> ST7789_FillRect
- >> ST7789_DrawString
- >> DrawCachedString
- >> __2snprintf
- >> strncmp
- >> strncpy

[Called By]

- >> DisplayUi_Task

GetTargetTemp (Thumb, 22 bytes, Stack size 0 bytes, display_ui.o(i.GetTargetTemp))

[Called By]

- >> DrawInfoRow
- >> DrawCurve

LowerModeText (Thumb, 68 bytes, Stack size 0 bytes, display_ui.o(i.LowerModeText))

[Called By]

- >> DrawInfoRow

PushTemp (Thumb, 74 bytes, Stack size 8 bytes, display_ui.o(i.PushTemp))

[Stack]

- Max Depth = 8
- Call Chain = PushTemp

[Called By]

- >> DrawCurve

ResetDrawCaches (Thumb, 104 bytes, Stack size 8 bytes, display_ui.o(i.ResetDrawCaches))

[Stack]

- Max Depth = 8
- Call Chain = ResetDrawCaches

[Calls]

- >> __aeabi_memset

[Called By]

- >> DisplayUi_Task
- >> DisplayUi_Init

TempToY (Thumb, 44 bytes, Stack size 0 bytes, display_ui.o(i.TempToY))

[Called By]

- >> DrawCurve

DrawGlyph16 (Thumb, 98 bytes, Stack size 40 bytes, ui_assets.o(i.DrawGlyph16))

[Stack]

- Max Depth = 112
- Call Chain = DrawGlyph16 ⇒ ST7789_DrawPixel ⇒ ST7789_SetAddressWindow ⇒ ST7789_WriteData16 ⇒ ST7789_WriteByte ⇒ SpiBusy

[Calls]

- >> ST7789_DrawPixel

[Called By]

- >> UiAssets_DrawText16

GetPhrase (Thumb, 82 bytes, Stack size 0 bytes, ui_assets.o(i.GetPhrase))

[Called By]

- >> UiAssets_DrawText16

DebugUart_KickLocked (Thumb, 124 bytes, Stack size 8 bytes, debug_uart.o(i.DebugUart_KickLocked))

[Stack]

- Max Depth = 8
- Call Chain = DebugUart_KickLocked

[Calls]

- >> DMA_SetCurrDataCounter
- >> DMA_Cmd
- >> DMA_ClearFlag

[Called By]

- >> DMA1_Channel4_IRQHandler
- >> DebugUart_PushByte

DebugUart_PushByte (Thumb, 50 bytes, Stack size 16 bytes, debug_uart.o(i.DebugUart_PushByte))

[Stack]

- Max Depth = 24
- Call Chain = DebugUart_PushByte ⇒ DebugUart_KickLocked

[Calls]

- >> DebugUart_KickLocked

[Called By]

- >> DebugUart_Write
- >> DebugUart_Printf

QueuePushFromIrq (Thumb, 122 bytes, Stack size 8 bytes, esp_uart.o(i.QueuePushFromIrq))

[Stack]

- Max Depth = 8
- Call Chain = QueuePushFromIrq

[Called By]

- >> USART2_IRQHandler

IsFrameChar (Thumb, 18 bytes, Stack size 0 bytes, lower_uart.o(i.IsFrameChar))

[Called By]

- >> USART3_IRQHandler

QueuePushFromIrq (Thumb, 118 bytes, Stack size 8 bytes, lower_uart.o(i.QueuePushFromIrq))

[Stack]

- Max Depth = 8
- Call Chain = QueuePushFromIrq

[Called By]

- >> USART3_IRQHandler

Relay_Pin (Thumb, 36 bytes, Stack size 0 bytes, relay.o(i.Relay_Pin))

[Called By]

- >> Relay_Set

Presence_ConvertRaw (Thumb, 2 bytes, Stack size 0 bytes, presence.o(i.Presence_ConvertRaw))

[Called By]

- >> Presence_Task

HandleLine (Thumb, 192 bytes, Stack size 48 bytes, esp01s.o(i.HandleLine))

[Stack]

- Max Depth = 136
- Call Chain = HandleLine ⇒ atoi ⇒ strtol ⇒ _strtoul

[Calls]

- >> StoreIp
- >> ParseField
- >> atoi
- >> strncmp
- >> __aeabi_memclr4

[Called By]

- >> ESP01S_Task

ParseField (Thumb, 106 bytes, Stack size 32 bytes, esp01s.o(i.ParseField))

[Stack]

- Max Depth = 44
- Call Chain = ParseField ⇒ strstr

[Calls]

- >> strlen
- >> strstr

[Called By]

- >> HandleLine

StoreIp (Thumb, 52 bytes, Stack size 16 bytes, esp01s.o(i.StoreIp))

[Stack]

- Max Depth = 24
- Call Chain = StoreIp ⇒ strncpy

[Calls]

- >> strncpy

[Called By]

- >> HandleLine

ApplyStatusFrame (Thumb, 84 bytes, Stack size 24 bytes, lower_link.o(i.ApplyStatusFrame))

[Stack]

- Max Depth = 36
- Call Chain = ApplyStatusFrame ⇒ CopyDebugText

[Calls]

- >> CopyDebugText
- >> strncpy

[Called By]

- >> LowerLink_Task

CopyDebugText (Thumb, 70 bytes, Stack size 12 bytes, lower_link.o(i.CopyDebugText))

[Stack]

- Max Depth = 12
- Call Chain = CopyDebugText

[Called By]

- >> SetLowerRxActivityError
- >> SetLowerError
- >> ApplyStatusFrame

CountFields (Thumb, 38 bytes, Stack size 0 bytes, lower_link.o(i.CountFields))

[Called By]

- >> ParseStatusFrame

IsValidMode (Thumb, 22 bytes, Stack size 8 bytes, lower_link.o(i.IsValidMode))

[Stack]

- Max Depth = 8
- Call Chain = IsValidMode

[Calls]

- >> strchr

[Called By]

- >> ParseStatusFrame

ParseNumber (Thumb, 78 bytes, Stack size 24 bytes, lower_link.o(i.ParseNumber))

[Stack]

- Max Depth = 96
- Call Chain = ParseNumber ⇒ strtol ⇒ _strtoul

[Calls]

- >> strtol

[Called By]

- >> ParseNumberField

ParseNumberField (Thumb, 38 bytes, Stack size 24 bytes, lower_link.o(i.ParseNumberField))

[Stack]

- Max Depth = 120
- Call Chain = ParseNumberField ⇒ ParseNumber ⇒ strtol ⇒ _strtoul

[Calls]

- >> ParseNumber

[Called By]

- >> ParseStatusFrame

ParseStatusFrame (Thumb, 198 bytes, Stack size 24 bytes, lower_link.o(i.ParseStatusFrame))

[Stack]

- Max Depth = 144
- Call Chain = ParseStatusFrame ⇒ ParseNumberField ⇒ ParseNumber ⇒ strtol ⇒ _strtoul

[Calls]

- >> ParseNumberField
- >> IsValidMode
- >> CountFields
- >> strncmp

[Called By]

- >> LowerLink_Task

SetLowerError (Thumb, 34 bytes, Stack size 16 bytes, lower_link.o(i.SetLowerError))

[Stack]

- Max Depth = 28
- Call Chain = SetLowerError ⇒ CopyDebugText

[Calls]

- >> CopyDebugText

[Called By]

- >> LowerLink_Task

SetLowerRxActivityError (Thumb, 30 bytes, Stack size 16 bytes, lower_link.o(i.SetLowerRxActivityError))

[Stack]

- Max Depth = 44
- Call Chain = SetLowerRxActivityError ⇒ LowerUart_GetRecentHex

[Calls]

- >> CopyDebugText
- >> LowerUart_GetRecentHex

[Called By]

- >> LowerLink_Task

ST7789_GPIO_Init (Thumb, 412 bytes, Stack size 104 bytes, st7789.o(i.ST7789_GPIO_Init))

[Stack]

- Max Depth = 128
- Call Chain = ST7789_GPIO_Init ⇒ GPIO_Init

[Calls]

- >> RCC_APB2PeriphClockCmd
- >> RCC_AHBPeriphClockCmd
- >> GPIO_Init
- >> DMA_Init
- >> DMA_ITConfig
- >> DMA_DeInit
- >> TIM_TimeBaseInit
- >> TIM_Cmd
- >> NVIC_Init
- >> TIM_OC1PreloadConfig
- >> TIM_OC1Init
- >> TIM_CtrlPWMOutputs
- >> TIM_ARRPreloadConfig
- >> SPI_Init
- >> SPI_I2S_DMACmd
- >> SPI_Cmd
- >> ST7789_SetBacklight
- >> GPIO_SetBits

[Called By]

- >> ST7789_Init

ST7789_SetAddressWindow (Thumb, 74 bytes, Stack size 32 bytes, st7789.o(i.ST7789_SetAddressWindow))

[Stack]

- Max Depth = 56
- Call Chain = ST7789_SetAddressWindow ⇒ ST7789_WriteData16 ⇒ ST7789_WriteByte ⇒ SpiBusy

[Calls]

- >> ST7789_WriteData16
- >> ST7789_WriteCommand

[Called By]

- >> ST7789_DrawPixel
- >> ST7789_FillRect

ST7789_StartDma (Thumb, 78 bytes, Stack size 8 bytes, st7789.o(i.ST7789_StartDma))

[Stack]

- Max Depth = 16
- Call Chain = ST7789_StartDma ⇒ SpiBusy

[Calls]

- >> DMA_SetCurrDataCounter
- >> DMA_Cmd
- >> DMA_ClearFlag
- >> SpiBusy
- >> GPIO_SetBits

[Called By]

- >> ST7789_Task

ST7789_WaitReady (Thumb, 18 bytes, Stack size 8 bytes, st7789.o(i.ST7789_WaitReady))

[Stack]

- Max Depth = 32
- Call Chain = ST7789_WaitReady ⇒ ST7789_Task ⇒ ST7789_StartDma ⇒ SpiBusy

[Calls]

- >> ST7789_Task
- >> ST7789_IsBusy

[Called By]

- >> ST7789_DrawPixel
- >> ST7789_FillRect

ST7789_WriteByte (Thumb, 38 bytes, Stack size 8 bytes, st7789.o(i.ST7789_WriteByte))

[Stack]

- Max Depth = 16
- Call Chain = ST7789_WriteByte ⇒ SpiBusy

[Calls]

- >> SPI_I2S_SendData
- >> SPI_I2S_GetFlagStatus
- >> SpiBusy

[Called By]

- >> ST7789_WriteData8
- >> ST7789_WriteData16
- >> ST7789_WriteCommand

ST7789_WriteCommand (Thumb, 20 bytes, Stack size 8 bytes, st7789.o(i.ST7789_WriteCommand))

[Stack]

- Max Depth = 24
- Call Chain = ST7789_WriteCommand ⇒ ST7789_WriteByte ⇒ SpiBusy

[Calls]

- >> ST7789_WriteByte
- >> GPIO_ResetBits

[Called By]

- >> ST7789_Init
- >> ST7789_SetAddressWindow

ST7789_WriteData16 (Thumb, 26 bytes, Stack size 8 bytes, st7789.o(i.ST7789_WriteData16))

[Stack]

- Max Depth = 24
- Call Chain = ST7789_WriteData16 ⇒ ST7789_WriteByte ⇒ SpiBusy

[Calls]

- >> ST7789_WriteByte
- >> GPIO_SetBits

[Called By]

- >> ST7789_DrawPixel
- >> ST7789_FillRect
- >> ST7789_SetAddressWindow

ST7789_WriteData8 (Thumb, 20 bytes, Stack size 8 bytes, st7789.o(i.ST7789_WriteData8))

[Stack]

- Max Depth = 24
- Call Chain = ST7789_WriteData8 ⇒ ST7789_WriteByte ⇒ SpiBusy

[Calls]

- >> ST7789_WriteByte
- >> GPIO_SetBits

[Called By]

- >> ST7789_Init

SpiBusy (Thumb, 20 bytes, Stack size 8 bytes, st7789.o(i.SpiBusy))

[Stack]

- Max Depth = 8
- Call Chain = SpiBusy

[Calls]

- >> SPI_I2S_GetFlagStatus

[Called By]

- >> ST7789_Task
- >> ST7789_IsBusy
- >> ST7789_WriteByte
- >> ST7789_StartDma

_fp_digits (Thumb, 366 bytes, Stack size 64 bytes, printfa.o(i._fp_digits), UNUSED)

[Calls]

- >> __aeabi_uldivmod
- >> __aeabi_dmul
- >> __aeabi_ddiv
- >> __aeabi_dadd
- >> __aeabi_d2ulz
- >> __aeabi_cdrcmple

[Called By]

- >> _printf_core

_printf_core (Thumb, 1744 bytes, Stack size 136 bytes, printfa.o(i._printf_core), UNUSED)

[Calls]

- >> __aeabi_uldivmod
- >> __aeabi_uidivmod
- >> _printf_pre_padding
- >> _printf_post_padding
- >> _fp_digits

[Called By]

- >> __0vsnprintf
- >> __0snprintf

_printf_post_padding (Thumb, 36 bytes, Stack size 24 bytes, printfa.o(i._printf_post_padding), UNUSED)

[Called By]

- >> _printf_core

_printf_pre_padding (Thumb, 46 bytes, Stack size 24 bytes, printfa.o(i._printf_pre_padding), UNUSED)

[Called By]

- >> _printf_core

_snputc (Thumb, 22 bytes, Stack size 0 bytes, printfa.o(i._snputc))
[Address Reference Count : 2]

- printfa.o(i.__0vsnprintf)
- printfa.o(i.__0snprintf)

### Undefined Global Symbols
