AnturyXD/Soldering-stationV2/docs/images/control-board-uart-wiring.jpg

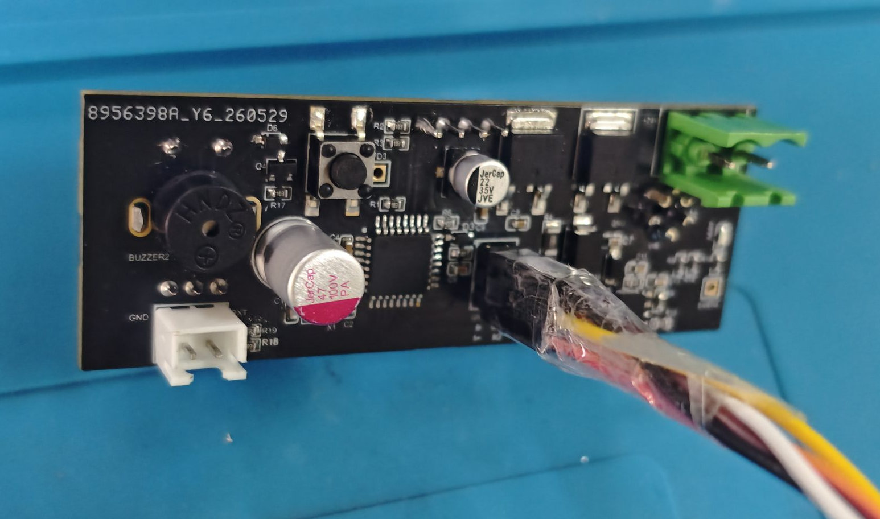
docs/images/control-board-uart-wiring.jpg
