AnturyXD/Soldering-stationV2/控温板/Hardware/SCH_智能焊台控制板_2026-06-07.pdf

## 电源指示灯

## 下载接口

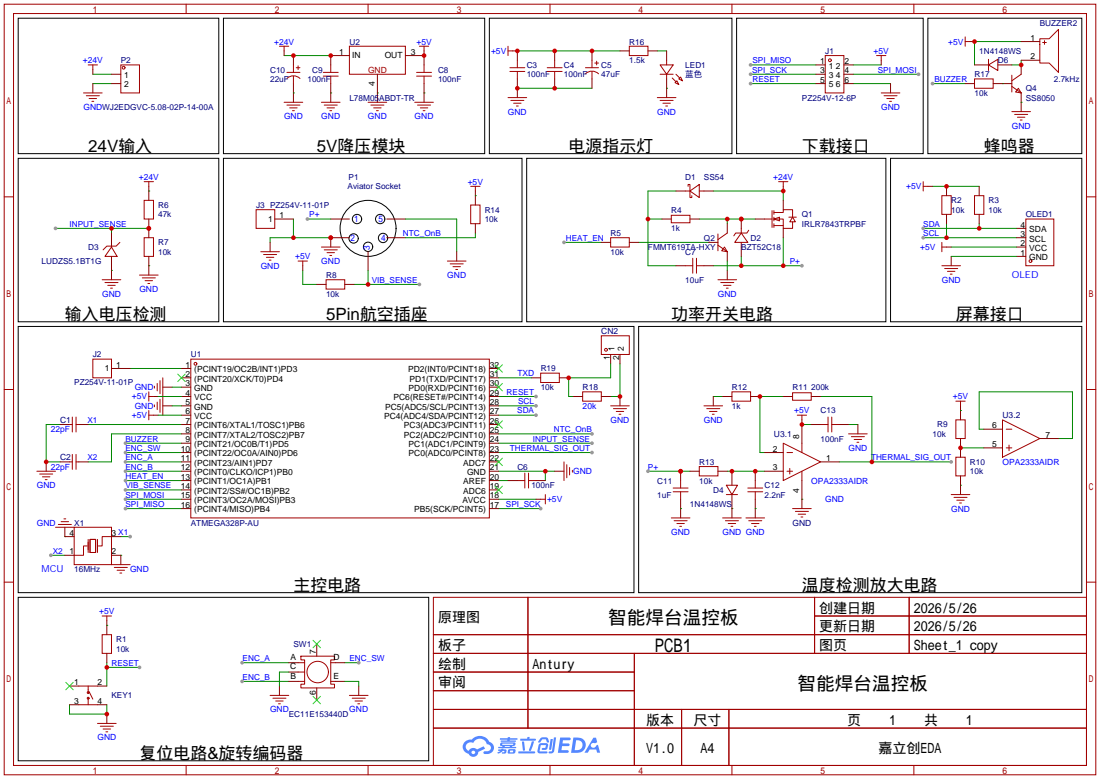
[picture p24: page 1]

原理图 | 智能焊台温控板 | 创建日期 | 2026/5/26

更新日期 | 2026/5/26

板子 | PCB1 | 图页 | Sheet_1 copy
绘制 | Antury | 智能焊台温控板
审阅

V1.0 | A4 | 嘉立创EDA
