AnturyXD/Soldering-stationV2/拓展板/Hardware/原理图-焊台拓展板.pdf

24V-5V降压电路 | 5V-3V3降压电路
24V输入 | USB-TYPE-C接口

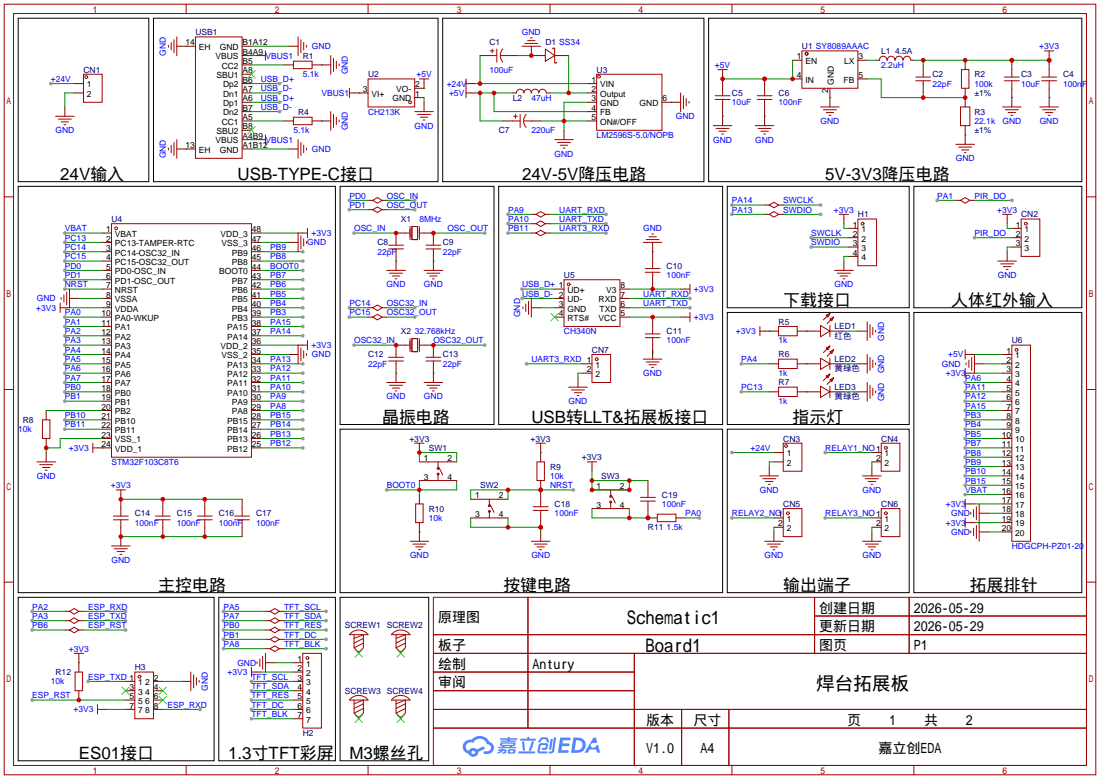
[picture p25: page 1]

USB1
GND A1B12 VBUS A4B9 SBU2 B8 CC1 A5 Dn2 B7 Dp1 A6 Dn1 A7 Dp2 B6 SBU1 A8 CC2 B5 VBUS B4A9 GND B1A12 EH 14

原理图 | Schematic1 | 创建日期 | 2026-05-29

更新日期 | 2026-05-29

板子 | Board1 | 图页 | P1
绘制 | Antury | 焊台拓展板
审阅

V1.0 | A4 | 嘉立创EDA

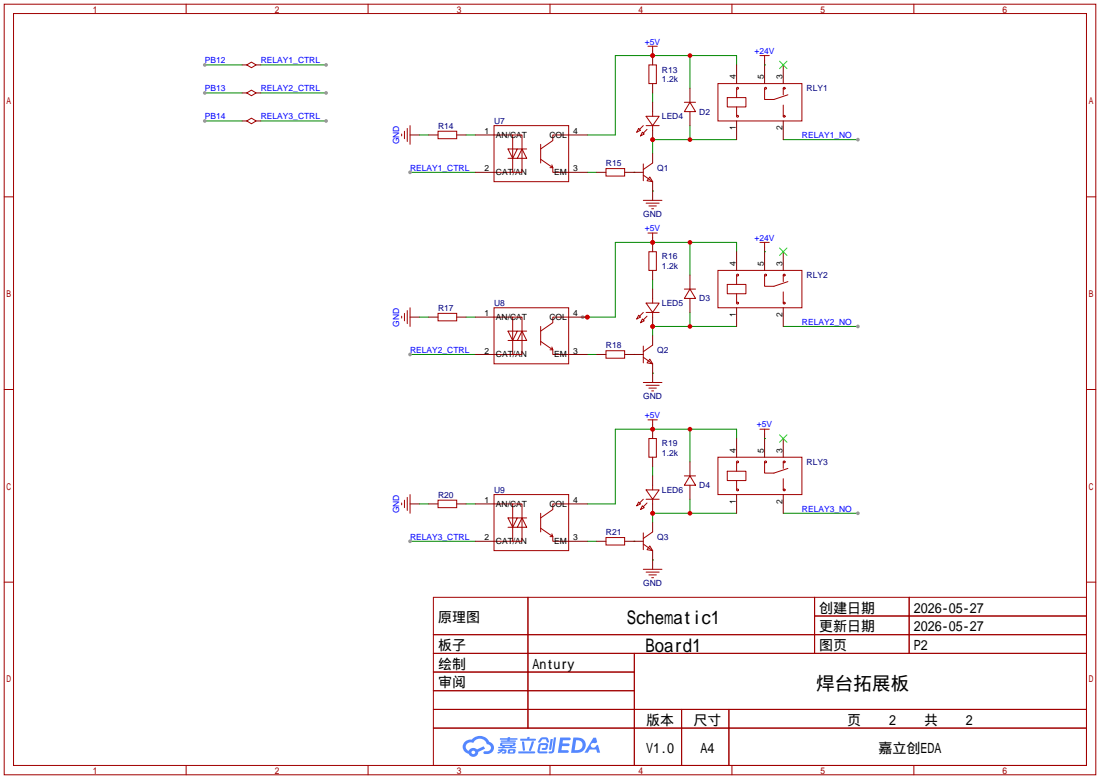
[picture p26: page 2]

原理图 | Schematic1 | 创建日期 | 2026-05-27

更新日期 | 2026-05-27

板子 | Board1 | 图页 | P2
绘制 | Antury | 焊台拓展板
审阅

V1.0 | A4 | 嘉立创EDA
