AnturyXD/Soldering-stationV2/拓展板/Firmware/SmartSolder_Extension/C8T6/APP/app_state.c

#include "app_state.h"
#include <string.h>

void AppState_Init(AppState_t *state)
{
    if (state == 0)
    {
        return;
    }

    memset(state, 0, sizeof(*state));
    state->mode = APP_MODE_MANUAL;
    state->lowerMode = 'O';
    state->ironTemp = -1;
    state->setTemp = 350;
    strcpy(state->ip, "0.0.0.0");
    strcpy(state->lowerLastError, "NO_RX");
    strcpy(state->lowerLastRaw, "");
    strcpy(state->lastDebug, "boot");
}

const char *AppMode_ToText(AppMode_t mode)
{
    return (mode == APP_MODE_AUTO) ? "AUTO" : "MANUAL";
}
