AnturyXD/Soldering-stationV2/拓展板/Firmware/SmartSolder_Extension/C8T6/HARDWARE/ST7789/st7789.h

#ifndef __ST7789_H
#define __ST7789_H

#include "stm32f10x.h"

#define ST7789_WIDTH   240U
#define ST7789_HEIGHT  240U

#define ST7789_COLOR_BLACK     0x0000
#define ST7789_COLOR_WHITE     0xFFFF
#define ST7789_COLOR_RED       0xF800
#define ST7789_COLOR_GREEN     0x07E0
#define ST7789_COLOR_BLUE      0x001F
#define ST7789_COLOR_CYAN      0x07FF
#define ST7789_COLOR_YELLOW    0xFFE0
#define ST7789_COLOR_MAGENTA   0xF81F
#define ST7789_COLOR_DARKGRAY  0x4208

void ST7789_Init(void);
void ST7789_Task(void);
uint8_t ST7789_IsBusy(void);
void ST7789_SetBacklight(uint8_t percent);
void ST7789_FillScreen(uint16_t color);
void ST7789_FillRect(uint16_t x, uint16_t y, uint16_t w, uint16_t h, uint16_t color);
uint8_t ST7789_StartFillRectAsync(uint16_t x, uint16_t y, uint16_t w, uint16_t h, uint16_t color);
void ST7789_DrawPixel(uint16_t x, uint16_t y, uint16_t color);
void ST7789_DrawLine(uint16_t x0, uint16_t y0, uint16_t x1, uint16_t y1, uint16_t color);
void ST7789_DrawChar(uint16_t x, uint16_t y, char ch, uint16_t color, uint16_t bg, uint8_t scale);
void ST7789_DrawString(uint16_t x, uint16_t y, const char *str, uint16_t color, uint16_t bg, uint8_t scale);

#endif
