AnturyXD/Soldering-stationV2/拓展板/Firmware/SmartSolder_Extension/C8T6/SYSTEM/timer/timer.c

#include "timer.h"

static volatile uint32_t systemMs;

void Timer_Init1ms(void)
{
    TIM_TimeBaseInitTypeDef tim;
    NVIC_InitTypeDef nvic;

    RCC_APB1PeriphClockCmd(RCC_APB1Periph_TIM3, ENABLE);

    tim.TIM_Period = 1000 - 1;
    tim.TIM_Prescaler = 72 - 1;
    tim.TIM_ClockDivision = TIM_CKD_DIV1;
    tim.TIM_CounterMode = TIM_CounterMode_Up;
    tim.TIM_RepetitionCounter = 0;
    TIM_TimeBaseInit(TIM3, &tim);

    TIM_ClearFlag(TIM3, TIM_FLAG_Update);
    TIM_ITConfig(TIM3, TIM_IT_Update, ENABLE);

    nvic.NVIC_IRQChannel = TIM3_IRQn;
    nvic.NVIC_IRQChannelPreemptionPriority = 2;
    nvic.NVIC_IRQChannelSubPriority = 0;
    nvic.NVIC_IRQChannelCmd = ENABLE;
    NVIC_Init(&nvic);

    TIM_Cmd(TIM3, ENABLE);
}

uint32_t Timer_GetMs(void)
{
    uint32_t value;

    __disable_irq();
    value = systemMs;
    __enable_irq();

    return value;
}

void TIM3_IRQHandler(void)
{
    if (TIM_GetITStatus(TIM3, TIM_IT_Update) != RESET)
    {
        TIM_ClearITPendingBit(TIM3, TIM_IT_Update);
        systemMs++;
    }
}
