AnturyXD/Soldering-stationV2/拓展板/Firmware/SmartSolder_Extension/C8T6/APP/ui_assets.c

#include "ui_assets.h"
#include "st7789.h"

static const uint8_t zh_gong_16[32] =
{
    0x00U, 0x00U, 0x3FU, 0xFCU, 0x3FU, 0xFCU, 0x01U, 0x80U,
    0x01U, 0x80U, 0x01U, 0x80U, 0x01U, 0x80U, 0x01U, 0x80U,
    0x01U, 0x80U, 0x01U, 0x80U, 0x01U, 0x80U, 0x01U, 0x80U,
    0x7FU, 0xFEU, 0x7FU, 0xFEU, 0x00U, 0x00U, 0x00U, 0x00U
};

static const uint8_t zh_zuo_16[32] =
{
    0x00U, 0x00U, 0x0CU, 0xC0U, 0x18U, 0xC0U, 0x19U, 0x80U,
    0x19U, 0xFEU, 0x33U, 0x40U, 0x76U, 0x40U, 0x70U, 0x7CU,
    0x50U, 0x40U, 0x10U, 0x40U, 0x10U, 0x40U, 0x10U, 0x7EU,
    0x10U, 0x40U, 0x18U, 0x40U, 0x18U, 0x40U, 0x10U, 0x40U
};

static const uint8_t zh_zhong_16[32] =
{
    0x01U, 0x80U, 0x01U, 0x80U, 0x01U, 0x80U, 0x3FU, 0xFCU,
    0x31U, 0x8CU, 0x21U, 0x84U, 0x21U, 0x84U, 0x21U, 0x84U,
    0x3FU, 0xFCU, 0x21U, 0x84U, 0x01U, 0x80U, 0x01U, 0x80U,
    0x01U, 0x80U, 0x01U, 0x80U, 0x01U, 0x00U, 0x00U, 0x00U
};

static const uint8_t zh_zai_16[32] =
{
    0x00U, 0x00U, 0x03U, 0x00U, 0x03U, 0x00U, 0x3FU, 0xFEU,
    0x3FU, 0xFEU, 0x06U, 0x40U, 0x0CU, 0x60U, 0x1CU, 0x60U,
    0x1BU, 0xFCU, 0x3BU, 0xFCU, 0x78U, 0x60U, 0x18U, 0x60U,
    0x18U, 0x60U, 0x1AU, 0x66U, 0x1FU, 0xFEU, 0x18U, 0x00U
};

static const uint8_t zh_xian_16[32] =
{
    0x10U, 0xC0U, 0x10U, 0xD8U, 0x30U, 0x48U, 0x24U, 0x4CU,
    0x6DU, 0xF8U, 0x7BU, 0xC0U, 0x18U, 0x5EU, 0x13U, 0xF0U,
    0x70U, 0x6CU, 0x7CU, 0x78U, 0x00U, 0x30U, 0x3EU, 0x70U,
    0x71U, 0xDAU, 0x03U, 0x0EU, 0x00U, 0x00U, 0x00U, 0x00U
};

static const uint8_t zh_li_16[32] =
{
    0x00U, 0x00U, 0x01U, 0x80U, 0x7FU, 0xFEU, 0x04U, 0x20U,
    0x17U, 0xE0U, 0x33U, 0xECU, 0x16U, 0x34U, 0x3FU, 0xFCU,
    0x01U, 0x80U, 0x03U, 0x80U, 0x3FU, 0xFEU, 0x26U, 0x26U,
    0x2FU, 0xF6U, 0x2FU, 0x96U, 0x20U, 0x0EU, 0x20U, 0x0CU
};

static const uint8_t zh_shou_16[32] =
{
    0x00U, 0x00U, 0x1FU, 0xFCU, 0x3FU, 0x80U, 0x01U, 0x80U,
    0x01U, 0x80U, 0x3FU, 0xFCU, 0x01U, 0x80U, 0x01U, 0x80U,
    0x7FU, 0xFEU, 0x01U, 0x80U, 0x01U, 0x80U, 0x01U, 0x80U,
    0x01U, 0x80U, 0x03U, 0x80U, 0x02U, 0x00U, 0x00U, 0x00U
};

static const uint8_t zh_dong_16[32] =
{
    0x00U, 0x30U, 0x00U, 0x30U, 0x7EU, 0x30U, 0x00U, 0xB0U,
    0x00U, 0xFEU, 0x7FU, 0x32U, 0x7FU, 0x32U, 0x10U, 0x22U,
    0x12U, 0x26U, 0x32U, 0x26U, 0x67U, 0x66U, 0x7FU, 0x46U,
    0x00U, 0xC6U, 0x01U, 0x9CU, 0x00U, 0x00U, 0x00U, 0x00U
};

static const uint8_t zh_zi_16[32] =
{
    0x00U, 0x00U, 0x03U, 0x00U, 0x03U, 0x00U, 0x1FU, 0xF8U,
    0x1FU, 0xFCU, 0x10U, 0x0CU, 0x1FU, 0xFCU, 0x1FU, 0xFCU,
    0x10U, 0x0CU, 0x1FU, 0xFCU, 0x1FU, 0xFCU, 0x10U, 0x0CU,
    0x10U, 0x0CU, 0x1FU, 0xFCU, 0x10U, 0x0CU, 0x00U, 0x00U
};

static const uint8_t zh_zhao_16[32] =
{
    0x01U, 0xFCU, 0x3DU, 0xFCU, 0x24U, 0x64U, 0x24U, 0x44U,
    0x24U, 0xCCU, 0x3DU, 0x9CU, 0x24U, 0xFCU, 0x24U, 0xC4U,
    0x24U, 0x84U, 0x3CU, 0xFCU, 0x00U, 0x00U, 0x24U, 0x4CU,
    0x26U, 0x64U, 0x62U, 0x66U, 0x40U, 0x00U, 0x00U, 0x00U
};

static const uint8_t zh_ming_16[32] =
{
    0x00U, 0x7CU, 0x7EU, 0xFEU, 0x66U, 0xC6U, 0x66U, 0xC4U,
    0x64U, 0xFCU, 0x7CU, 0xC4U, 0x64U, 0xC4U, 0x64U, 0xC4U,
    0x64U, 0xFCU, 0x7EU, 0x84U, 0x66U, 0x84U, 0x61U, 0x84U,
    0x01U, 0x84U, 0x03U, 0x1CU, 0x00U, 0x00U, 0x00U, 0x00U
};

static const uint8_t zh_pai_16[32] =
{
    0x10U, 0xD8U, 0x10U, 0xD8U, 0x10U, 0xD8U, 0x7FU, 0xDEU,
    0x78U, 0xD8U, 0x10U, 0xD8U, 0x13U, 0xDEU, 0x1FU, 0xDEU,
    0x70U, 0xD8U, 0x50U, 0xD8U, 0x13U, 0xDEU, 0x13U, 0xDEU,
    0x10U, 0xD8U, 0x70U, 0xD8U, 0x20U, 0x00U, 0x00U, 0x00U
};

static const uint8_t zh_feng_16[32] =
{
    0x00U, 0x00U, 0x3FU, 0xF8U, 0x30U, 0x18U, 0x10U, 0x58U,
    0x34U, 0x58U, 0x36U, 0xD8U, 0x33U, 0x98U, 0x31U, 0x98U,
    0x31U, 0x98U, 0x33U, 0xC8U, 0x26U, 0x48U, 0x2CU, 0x6AU,
    0x60U, 0x0EU, 0x40U, 0x06U, 0x00U, 0x00U, 0x00U, 0x00U
};

static const uint8_t *const phrase_working[] = { zh_gong_16, zh_zuo_16, zh_zhong_16 };
static const uint8_t *const phrase_online[] = { zh_zai_16, zh_xian_16 };
static const uint8_t *const phrase_offline[] = { zh_li_16, zh_xian_16 };
static const uint8_t *const phrase_manual[] = { zh_shou_16, zh_dong_16 };
static const uint8_t *const phrase_auto[] = { zh_zi_16, zh_dong_16 };
static const uint8_t *const phrase_light[] = { zh_zhao_16, zh_ming_16 };
static const uint8_t *const phrase_fan[] = { zh_pai_16, zh_feng_16 };

static const uint8_t *const *GetPhrase(UiTextZh_t text, uint8_t *count)
{
    switch (text)
    {
    case UI_TEXT_ZH_WORKING:
        *count = 3U;
        return phrase_working;
    case UI_TEXT_ZH_ONLINE:
        *count = 2U;
        return phrase_online;
    case UI_TEXT_ZH_OFFLINE:
        *count = 2U;
        return phrase_offline;
    case UI_TEXT_ZH_MANUAL:
        *count = 2U;
        return phrase_manual;
    case UI_TEXT_ZH_AUTO:
        *count = 2U;
        return phrase_auto;
    case UI_TEXT_ZH_LIGHT:
        *count = 2U;
        return phrase_light;
    case UI_TEXT_ZH_FAN:
        *count = 2U;
        return phrase_fan;
    default:
        *count = 0U;
        return 0;
    }
}

static void DrawGlyph16(uint16_t x, uint16_t y, const uint8_t *data, uint16_t fg, uint16_t bg)
{
    uint8_t row;
    uint8_t col;
    uint8_t byteValue;

    if (data == 0)
    {
        return;
    }

    for (row = 0U; row < UI_ZH_FONT_H; row++)
    {
        for (col = 0U; col < UI_ZH_FONT_W; col++)
        {
            byteValue = data[row * 2U + col / 8U];
            ST7789_DrawPixel((uint16_t)(x + col),
                             (uint16_t)(y + row),
                             (byteValue & (uint8_t)(0x80U >> (col % 8U))) ? fg : bg);
        }
    }
}

uint16_t UiAssets_TextWidth16(UiTextZh_t text)
{
    uint8_t count;

    (void)GetPhrase(text, &count);
    return (uint16_t)(count * UI_ZH_FONT_W);
}

void UiAssets_DrawText16(uint16_t x, uint16_t y, UiTextZh_t text, uint16_t fg, uint16_t bg)
{
    uint8_t count;
    uint8_t i;
    const uint8_t *const *phrase = GetPhrase(text, &count);

    for (i = 0U; i < count; i++)
    {
        DrawGlyph16((uint16_t)(x + i * UI_ZH_FONT_W), y, phrase[i], fg, bg);
    }
}
